UMSATS/SRAD-AvionicsComputer/SRAD_V2/SRAD_V2.csv

Reference | Manufacturer_Part_Number | Manufacturer_Name | DNP | Value | Footprint | Qty | Description | Digikey Link
C1,C4 | GRM1555C1H120FA01J | Murata Electronics |  | 12pF | Capacitor_SMD:C_0402_1005Metric | 2 | 12 pF ±1% 50V Ceramic Capacitor C0G, NP0 0402 (1005 Metric) | https://www.digikey.ca/en/products/detail/murata-electronics/GRM1555C1H120FA01J/4420263
C2,C3,C5,C6,C7,C8,C9,C10,C11,C13,C15,C16,C19,C20,C23,C24,C31,C32,C34,C37,C45,C48,C49,C51 | C0603C104K5RAC3121 | KEMET |  | 100nF | Capacitor_SMD:C_0603_1608Metric | 24 | CAP CER 0.1UF 50V X7R 0603 | https://www.digikey.ca/en/products/detail/kemet/C0603C104K5RAC3121/16680122?gclsrc=aw.ds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
C12,C27 | GRM155R71C103KA01D | Murata Electronics |  | 10nF | Capacitor_SMD:C_0402_1005Metric | 2 | 10000 pF ±10% 16V Ceramic Capacitor X7R 0402 (1005 Metric) | https://www.digikey.ca/en/products/detail/murata-electronics/GRM155R71C103KA01D/587215
C14,C17,C21,C25,C29,C30,C33,C44 | C0603C105K4RACTU | KEMET |  | 1uF | Capacitor_SMD:C_0603_1608Metric | 8 | CAP CER 1UF 16V X7R 0603 | https://www.digikey.ca/en/products/detail/kemet/C0603C105K4RACTU/2199788
C18,C22,C28,C35,C36,C41,C42,C46,C47,C50 | CGA5L1X7R1E106K160DC | TDK |  | 10uF | Capacitor_SMD:C_1206_3216Metric | 10 | 10 µF ±10% 25V Ceramic Capacitor X7R 1206 (3216 Metric) | https://www.digikey.com/en/products/detail/tdk/CGA5L1X7R1E106K160DC/22106123
C26 | C0402C470J3GACTU | KEMET |  | 47pF | Capacitor_SMD:C_0402_1005Metric | 1 | 47 pF ±5% 25V Ceramic Capacitor C0G, NP0 0402 (1005 Metric) | https://www.digikey.ca/en/products/detail/kemet/C0402C470J3GACTU/1933626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
C38,C39,C40 | GRM31CC81E226ME11L | Murata Electronics |  | 22uF | Capacitor_SMD:C_1206_3216Metric | 3 | CAP CER 22UF 25V X6S 1206 | https://www.digikey.com/en/products/detail/murata-electronics/GRM31CC81E226ME11L/7363058
D1,D3 | SMF10CA | Littelfuse Inc. |  | TVS diode | Diode_SMD:D_SOD-123F | 2 | TVS DIODE 10VWM 17VC SOD123F | https://www.digikey.ca/en/products/detail/littelfuse-inc/SMF10CA/11206210
D2,D8,D9,D10,D11 | MSS1P5-M3/89A | Vishay General Semiconductor - Diodes Division |  |  | Schottky_Diode:DIODE_MSP3V3 | 5 | DIODE SCHOTTKY 50V 1A DO219AD | https://www.digikey.ca/en/products/detail/vishay-general-semiconductor-diodes-division/mss1p5-m3-89a/2071754
D4 | MBRA340T3G | onsemi |  | Schottky Diode | Diode_SMD:D_SMA | 1 | 40V 3A Schottky Barrier Rectifier Diode, SMA(DO-214AC) | https://www.digikey.ca/en/products/detail/onsemi/MBRA340T3G/918606
D5,D6 | STS321050B100 | Eaton - Electronics Division |  | TVS diode | Diode_SMD:D_SOD-323 | 2 | 5V, 450W Discrete Bidirectional TVS Diode, SOD-323 | https://www.digikey.ca/en/products/detail/eaton-electronics-division/STS321050B100/13280469
D7 | PTVS3V3S1UTR,115 | Nexperia USA Inc. |  | TVS diode | PTVS3V3S1UTR_115:CR_PTVS3V_NEX-L | 1 | TVS DIODE 3.3VWM 8VC SOD123W | https://www.digikey.ca/en/products/detail/nexperia-usa-inc/PTVS3V3S1UTR-115/2780299
FB1 | MH1608-121Y | Bourns Inc. |  | 120R | Inductor_SMD:L_0603_1608Metric | 1 | Ferrite bead | https://www.digikey.ca/en/products/detail/bourns-inc/MH1608-121Y/2563311?gclsrc=aw.ds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
FU1,FU2,FU3,FU4 | SF-1206SP500M-2 | Bourns Inc. |  | Fuse_Small | Fuse:Fuse_1206_3216Metric_Pad1.42x1.75mm_HandSolder | 4 | Fuse, small symbol | https://www.digikey.ca/en/products/detail/bourns-inc/sf-1206sp500m-2/8548151
IC1 | STM32F767ZIT6 | STMicroelectronics |  |  | Package_QFP:LQFP-144_20x20mm_P0.5mm | 1 | STMicroelectronics Arm Cortex-M7 MCU, 2048KB flash, 512KB RAM, 216 MHz, 1.7-3.6V, 114 GPIO, LQFP144 | https://www.digikey.ca/en/products/detail/stmicroelectronics/STM32F767ZIT6/6004736
IC2 | LSM6DSVTR | STMicroelectronics |  |  | LGA14-L_2P59X3P1X0P5_STM | 1 | INEMO INERTIAL MODULE: 3D ACCELE | https://www.digikey.ca/en/products/detail/stmicroelectronics/LSM6DSVTR/17038915
IC3 | MAX-M10S-00B | u-blox |  |  | RF_GPS:ublox_MAX | 1 | GNSS Module MAX M10, VCC 1.65V to 3.6V | https://www.digikey.ca/en/products/detail/u-blox/MAX-M10S-00B/15712906
IC4 | MMC5983MA | Memsic Inc. |  |  | MMC5983MA:MMC5983MA_MEM | 1 | SEN MR I2C/SPI 16-LGA | https://www.digikey.ca/en/products/detail/memsic-inc/mmc5983ma/10452795
IC5 | AS5F31G04SND-08LIN | Alliance Memory, Inc. |  |  | NAND_Flash:SON127P600X800X80-8N | 1 | IC FLASH 1GBIT SPI/QUAD 8LGA | https://www.digikey.com/en/products/detail/alliance-memory-inc/AS5F31G04SND-08LIN/13282909
IC6 | MS560702BA03-50 | TE Connectivity Measurement Specialties |  |  | Package_LGA:LGA-8_3x5mm_P1.25mm | 1 | Barometric pressure sensor, 20cm resolution, 10 to 1200 mbar, I2C and SPI interface up to 20MHz, LGA-8 | https://www.digikey.ca/en/products/detail/te-connectivity-measurement-specialties/MS560702BA03-50/4700931
IC7 | TPS563200DDCT | Texas Instruments |  |  | Package_TO_SOT_SMD:SOT-23-6 | 1 | 3A Synchronous Step-Down Voltage Regulator, Adjustable Output Voltage, 4.5-17V Input Voltage, SOT-23-6 | https://www.digikey.ca/en/products/detail/texas-instruments/TPS563200DDCT/5012066
IC8 | TMCS1108A2UQDR | Texas Instruments |  |  | Current_Sensor:D0008A-IPC_A | 1 | SENSOR CURRENT HALL EFFECT 8SOIC | https://www.digikey.ca/en/products/detail/texas-instruments/TMCS1108A2UQDR/13692878
IC9,IC10 | NCV81071BZR2G | onsemi |  |  | Gate_Driver:SOP65P490X110-9N | 2 | Low-Side Gate Driver IC CMOS, TTL 8-MSOP-EP | https://www.digikey.ca/en/products/detail/onsemi/NCV81071BZR2G/25602407
IC11 | TS941ILT | STMicroelectronics |  | op-amp | SOT23-5L_STM | 1 | IC OP AMP 1CH SOT-23-5 | https://www.digikey.ca/en/products/detail/stmicroelectronics/ts941ilt/720968
J3 | RSP-122811-02 | Samtec Inc. |  |  | RSP_122811_02-2:SAMTEC_RSP-122811-02 | 1 | CONN IPEX MHF3 RCP STR 50OHM SMD | https://www.digikey.ca/en/products/detail/samtec-inc/RSP-122811-02/6678589
L1 | LQG15HS27NH02D | Murata Electronics |  | 27nH | Inductor_SMD:L_0402_1005Metric | 1 | Inductor, small symbol | https://www.digikey.ca/en/products/detail/murata-electronics/lqg15hs27nh02d/6798538
L2 | SRP5030TA-2R2M | Bourns Inc. |  | 2.2uH | Inductor_SMD:L_Bourns_SRP5030T | 1 | FIXED IND 2.2UH 5.5A 35 MOHM SMD | https://www.digikey.ca/en/products/detail/bourns-inc/srp5030ta-2r2m/5429671
LED1,LED2,LED3 | 150120SS75000 | Würth Elektronik |  | LED | 150120SS75000:WL-SMCW_1206 | 3 | RED SMD LED | https://www.digikey.ca/en/products/detail/würth-elektronik/150120SS75000/4489942?_gl=1*tss2ya*_up*MQ..*_gs*MQ..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
Q1,Q2,Q3,Q4 | NTMFS5C673NT1G | onsemi |  | MOSFET N-CH | NTMFS5C673NT1G-2:TRANS_NTMFS5C673NT1G | 4 | MOSFET N-CH 60V 14A/50A 5DFN | https://www.digikey.ca/en/products/detail/onsemi/ntmfs5c673nt1g/12525778
Q5 | MMBT3904LT3G | onsemi |  | NPN BJT | Package_TO_SOT_SMD:SOT-23 | 1 | TRANS NPN 40V 0.2A SOT23-3 | https://www.digikey.ca/en/products/detail/onsemi/mmbt3904lt3g/919602
R1,R4,R15,R20,R21,R22,R23 | CRT0603-BY-1002ELF | Bourns Inc. |  | 10k | Resistor_SMD:R_0603_1608Metric | 7 | RES SMD 10K OHM 0.1% 1/10W 0603 | https://www.digikey.ca/en/products/detail/bourns-inc/crt0603-by-1002elf/1775019
R2,R7,R10,R11,R24 | RT0603BRD07806RL | YAGEO |  | 806R | Resistor_SMD:R_0603_1608Metric | 5 | 806 Ohms ±0.1% 0.1W, 1/10W Chip Resistor 0603 (1608 Metric) Thin Film | https://www.digikey.ca/en/products/detail/yageo/RT0603BRD07806RL/1072652
R3,R5,R6,R9,R12,R13 | CRCW06034K70FKEAHP | Vishay Dale |  | 4.7k | Resistor_SMD:R_0603_1608Metric | 6 | RES SMD 4.7K OHM 1% 1/3W 0603 | https://www.digikey.ca/en/products/detail/vishay-dale/CRCW06034K70FKEAHP/2222257
R8,R16,R17,R18,R19 | RC1206JR-7W10RL | YAGEO |  | 10R | Resistor_SMD:R_1206_3216Metric | 5 | RES 10 OHM 5% 1/2W 1206 | https://www.digikey.ca/en/products/detail/yageo/RC1206JR-7W10RL/12698862?gclsrc=aw.ds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
R14 | CRCW060333K2FKTA | Vishay Dale |  | 33.2k | Resistor_SMD:R_0603_1608Metric | 1 | RES SMD 33.2K OHM 1% 1/10W 0603 | https://www.digikey.ca/en/products/detail/vishay-dale/crcw060333k2fkta/1222007
R25 | CRG0603F68K | TE Connectivity Passive Product |  | 68k | Resistor_SMD:R_0603_1608Metric | 1 | RES SMD 68K OHM 1% 1/10W 0603 | https://www.digikey.ca/en/products/detail/te-connectivity-passive-product/crg0603f68k/2380803
R26 | RT0603FRD07100KL | YAGEO |  | 100k | Resistor_SMD:R_0603_1608Metric | 1 | RES SMD 100K OHM 1% 1/10W 0603 | https://www.digikey.ca/en/products/detail/yageo/rt0603frd07100kl/5928951
R27 | RMCF0603JT20K0 | Stackpole Electronics Inc |  | 20k | Resistor_SMD:R_0603_1608Metric | 1 | RES 20K OHM 5% 1/10W 0603 | https://www.digikey.ca/en/products/detail/stackpole-electronics-inc/rmcf0603jt20k0/1758001
R28 | RT0603FRE07510KL | YAGEO |  | 500k | Resistor_SMD:R_0603_1608Metric | 1 | RES SMD 510K OHM 1% 1/10W 0603 | https://www.digikey.ca/en/products/detail/yageo/rt0603fre07510kl/5929192
SW1 | SLW-913535-2A-SMT | Same Sky (Formerly CUI Devices) |  |  | spdt_switch:SW_SLW-913535-2A-SMT | 1 | SWITCH SLIDE DPDT 0.1A 12V | https://www.digikey.ca/en/products/detail/omron-electronics-inc-emc-div/B3U-1100P/1534339?gclsrc=aw.ds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
SW2 | B3U-1100P | Aratas (Formerly Omron Components) |  |  | push_button:SW_TS18-5-15-SL-160-SMT-TR | 1 | SWITCH TACTILE SPST-NO 0.05A 12V | https://www.digikey.ca/en/products/detail/omron-electronics-inc-emc-div/B3U-1100P/1534339?gclsrc=aw.ds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
U1 | LM4040CYM3-4.1-TR | Microchip Technology |  | Vol Ref. | Package_TO_SOT_SMD:SOT-23 | 1 | Shunt Voltage Reference IC Fixed 4.096V V ±0.5% 15 mA SOT-23-3 | https://www.digikey.ca/en/products/detail/microchip-technology/lm4040cym3-4-1-tr/1027695
USB1 | USB4105-GF-A | GCT |  | USB_C_Receptacle_USB2.0_16P | Connector_USB:USB_C_Receptacle_GCT_USB4105-xx-A_16P_TopMnt_Horizontal | 1 | USB 2.0-only 16P Type-C Receptacle connector | https://www.digikey.ca/en/products/detail/gct/USB4105-GF-A/11198441
X1 | VXM7-9032-25M0000000 | Microchip Technology |  | Crystal | VXM7_9032_25M0000000:VXM7_MCH | 1 | CRYSTAL 25.0000MHZ SMD | https://www.digikey.ca/en/products/detail/microchip-technology/VXM7-9032-25M0000000/13175115
BZ1 | CI12E-05T230-C-6 | Challenge Electronics | DNP | Buzzer | Buzzer_Beeper:Buzzer_12x9.5RM7.6 | 1 | Buzzer, polarized | https://www.digikey.ca/en/products/detail/challenge-electronics/CI12E-05T230-C-6/21262928
C43 | A750MW228M1CAAE010 | KEMET | DNP | 2200uF | Capacitor_THT:CP_Radial_D10.0mm_P5.00mm | 1 | CAP ALUM POLY 2200UF 20% 16V TH | https://www.digikey.ca/en/products/detail/kemet/A750MW228M1CAAE010/13420077
EM1,EM2,EM3,EM4 | 691210910002 | Würth Elektronik | DNP |  | Screw_Terminal:691210910002 | 4 | TERM BLOCK 2P HORIZON 2.54MM PCB | https://www.digikey.ca/en/products/detail/würth-elektronik/691210910002/10668428
J1,J6,J7 |  |  | DNP | Conn_01x04_Pin | Connector_PinHeader_2.54mm:PinHeader_1x04_P2.54mm_Vertical | 3 | Generic connector, single row, 01x04, script generated
J2,J4 | S02B-XASS-1 | JST Sales America Inc. | DNP |  | S02B-XASS-1:CONN2_S02B-XASS_295x496_JST | 2 | CONN HEADER R/A 2POS 2.5MM | https://www.digikey.ca/en/products/detail/jst-sales-america-inc/S02B-XASS-1/1634785
J5 |  |  | DNP | Conn_01x02_Pin | Connector_PinHeader_1.27mm:PinHeader_1x02_P1.27mm_Vertical | 1 | Generic connector, single row, 01x02, script generated
