UMSATS/SRAD-AvionicsComputer/SRAD_V2/SRAD_FC_PCB_LAYOUT.csv

 | Sourced | Placed | References | Value | Footprint | Quantity
1 |  |  | C3, C7, C8, C9, C11, C16, C18, C21, C23, C24, C25, C26, C27, C28, C29, C30, C31, C32, C33, C34, C39, C42, Cin4 | 100n | C_0603_1608Metric | 23
2 |  |  | C1, C2, C5, C6, C13, C14, C15, C20, C22, C35 | 10u | C_1206_3216Metric | 10
3 |  |  | C17, C36, C38, C45, C46, C47, C48, C49 | 1u | C_0603_1608Metric | 8
4 |  |  | C40, C41 | 12p | C_0402_1005Metric | 2
5 |  |  | C12 | 2200uF | CP_Radial_D10.0mm_P5.00mm | 1
6 |  |  | C19 | 10n | C_0402_1005Metric | 1
7 |  |  | C37 | 10n | R_0402_1005Metric | 1
8 |  |  | C44 | 47pF | C_0402_1005Metric | 1
9 |  |  | R2, R8, R9, R10, R11, R12, R17 | 10k | R_0603_1608Metric | 7
10 |  |  | R14, R15, R16, R18, R19, R21 | 4.7k | R_0603_1608Metric | 6
11 |  |  | R3, R4, R5, R6, R7 | 10R | R_1206_3216Metric | 5
12 |  |  | R13, R22, R23 | 806R | R_0603_1608Metric | 3
13 |  |  | R1 | 33.2k | R_0603_1608Metric | 1
14 |  |  | L1 | 2.2uH | IND_BOURNS_SRN8040 | 1
15 |  |  | L2 | 27n | L_0402_1005Metric | 1
16 |  |  | D5, D6 | SD05C-01F | D_SOD-323 | 2
17 |  |  | D7, D8 | MBR1020VL | D_SOD-123F | 2
18 |  |  | D1 | WL-SMCW_1206 | WL-SMCW_1206 | 1
19 |  |  | D4 | MBRA340 | D_SMA | 1
20 |  |  | U1 | STM32F767ZIT6 | LQFP-144_20x20mm_P0.5mm | 1
21 |  |  | U2 | TPS563200 | SOT-23-6 | 1
22 |  |  | U3 | TMCS1108A2UQDR | D0008A-IPC_A | 1
23 |  |  | U5 | LSM6DSVTR | LGA14-L_2P59X3P1X0P5_STM | 1
24 |  |  | U12 | MAX-M10S | ublox_MAX | 1
25 |  |  | U13 | MS5607-02BA | LGA-8_3x5mm_P1.25mm | 1
26 |  |  | U14 | MMC5983MA | MMC5983MA_MEM | 1
27 |  |  | U17 | AS5F31G04SND-08LIN | SON127P600X800X80-8N | 1
28 |  |  | X1 | Crystal | VXM7_MCH | 1
29 |  |  | F1, F2, F3, F4 | Fuse_Small | Fuse_1206_3216Metric_Pad1.42x1.75mm_HandSolder | 4
30 |  |  | CR1, CR2, CR3, CR4, CR6 | MSS1P5-M3/89A | DIODE_MSP3V3 | 5
31 |  |  | EM1, EM2, EM3, EM4 | 691210910002 | 691210910002 | 4
32 |  |  | Q1, Q2, Q3, Q4 | NTMFS5C673NT1G | TRANS_NTMFS5C673NT1G | 4
33 |  |  | Cout1, Cout2, Cout3 | 22uF | C_1206_3216Metric | 3
34 |  |  | IC1, IC2 | NCV81071BZR2G | SOP65P490X110-9N | 2
35 |  |  | BZ2 | Buzzer | Buzzer_12x9.5RM7.6 | 1
36 |  |  | CR5 | PTVS3V3S1UTR_115 | CR_PTVS3V_NEX-L | 1
37 |  |  | FB1 | 120R | L_0603_1608Metric | 1
38 |  |  | Q6 | MMBT3904LT3G | SOT-23 | 1
39 |  |  | S1 | TS18-5-15-SL-160-SMT-TR | SW_TS18-5-15-SL-160-SMT-TR | 1
40 |  |  | S2 | SLW-913535-2A-SMT | SW_SLW-913535-2A-SMT | 1
41 |  |  | J5, J7 | S02B-XASS-1LFSN | CONN2_S02B-XASS_295x496_JST | 2
42 |  |  | J1 | Conn_01x04_Pin | PinHeader_1x04_P2.54mm_Vertical | 1
43 |  |  | J2 | Conn_01x02_Pin | PinHeader_1x02_P1.27mm_Vertical | 1
44 |  |  | J3 | RSP-122811-02 | SAMTEC_RSP-122811-02 | 1
45 |  |  | J4 | USB_C_Receptacle_USB2.0_16P | USB_C_Receptacle_GCT_USB4105-xx-A_16P_TopMnt_Horizontal | 1
