UMSATS/SRAD-AvionicsComputer/Breakout Boards/Custom E-CAD Models/0.1uf Cap/ul_C0603C104K5RAC3121/CAP_C0603C104K5RAC3121_KEM.step

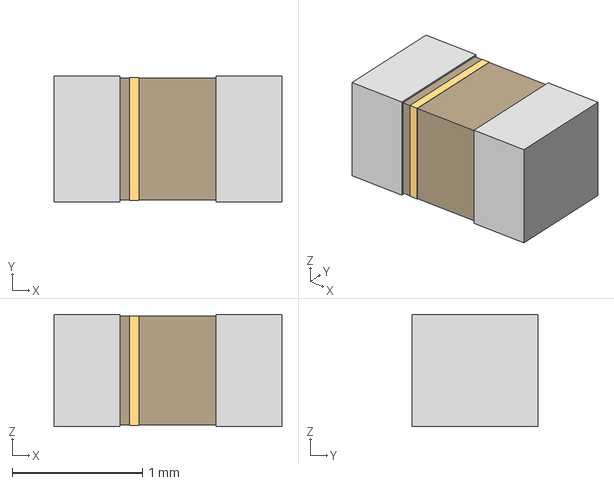
[picture p3: CAD file, 2026-09-25]
Breakout Boards/Custom E-CAD Models/0.1uf Cap/ul_C0603C104K5RAC3121/CAP_C0603C104K5RAC3121_KEM.step
1.75 x 0.966 x 0.864 mm
