UMSATS/SRAD-AvionicsComputer/Breakout Boards/Custom E-CAD Models/3D Models/2.7mF Polymer Capacitor/APSG160ELL272MJ20S.STEP

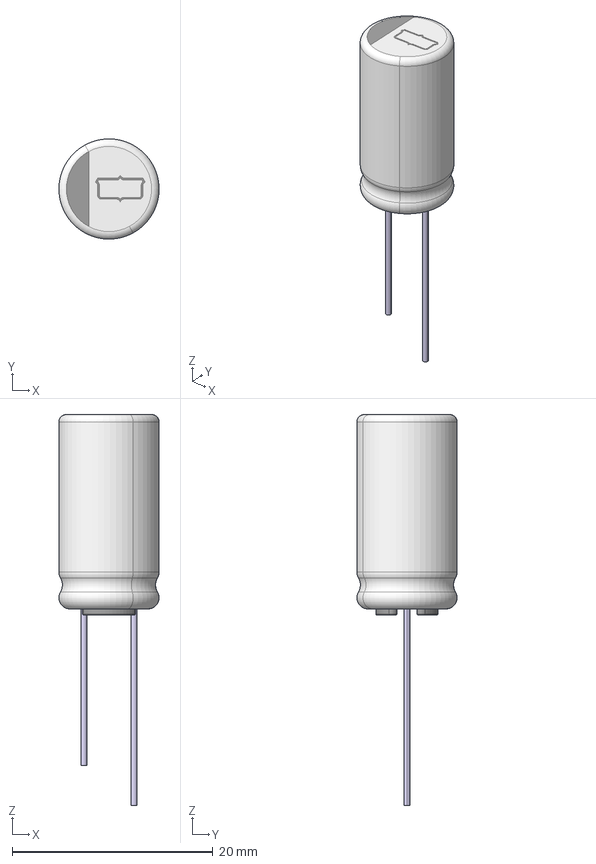
[picture p4: CAD file, 2026-09-25]
Breakout Boards/Custom E-CAD Models/3D Models/2.7mF Polymer Capacitor/APSG160ELL272MJ20S.STEP
10.00 x 10.00 x 39.0 mm
A-LEAD_D10_TERMINAL+
A-LEAD_D10_TERMINAL-
A-LEAD_D10_L20_ELEMENT
