UMSATS/SRAD-AvionicsComputer/Breakout Boards/Custom E-CAD Models/3D Models/GP_1575_18_4_A_02/gp_1575_18_4_a_02.stp

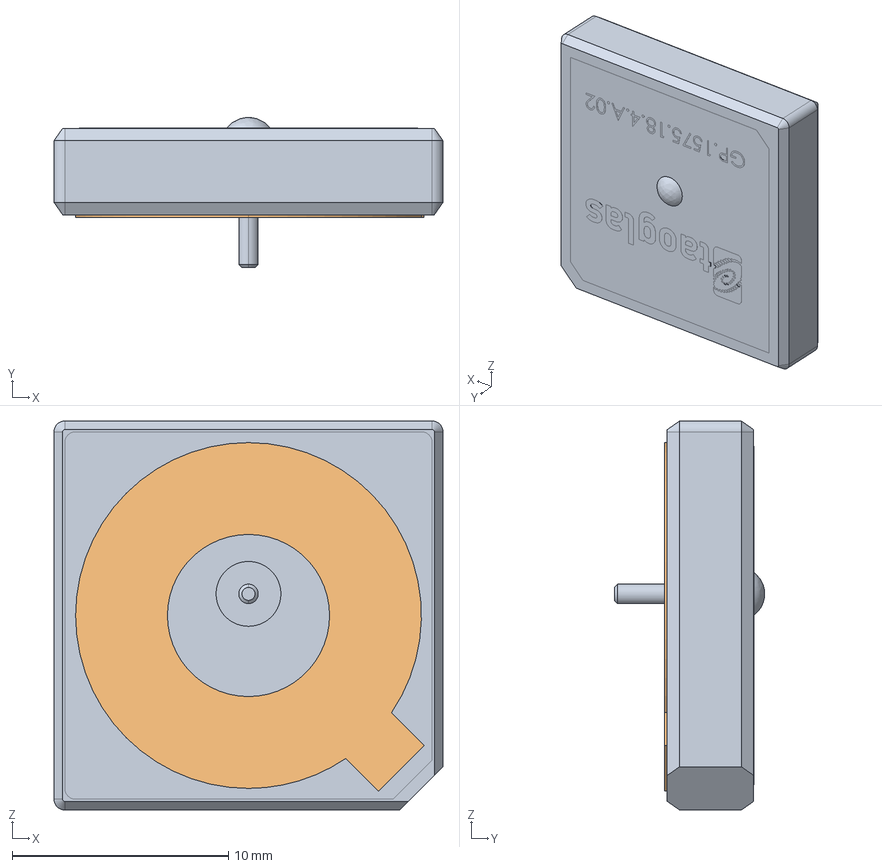
[picture p5: CAD file, 2026-09-25]
Breakout Boards/Custom E-CAD Models/3D Models/GP_1575_18_4_A_02/gp_1575_18_4_a_02.stp
18.0 x 6.96 x 18.0 mm
