UMSATS/SRAD-AvionicsComputer/Breakout Boards/Custom E-CAD Models/3D Models/Temp Sensor/DFN8_2x3MC_MCH.step

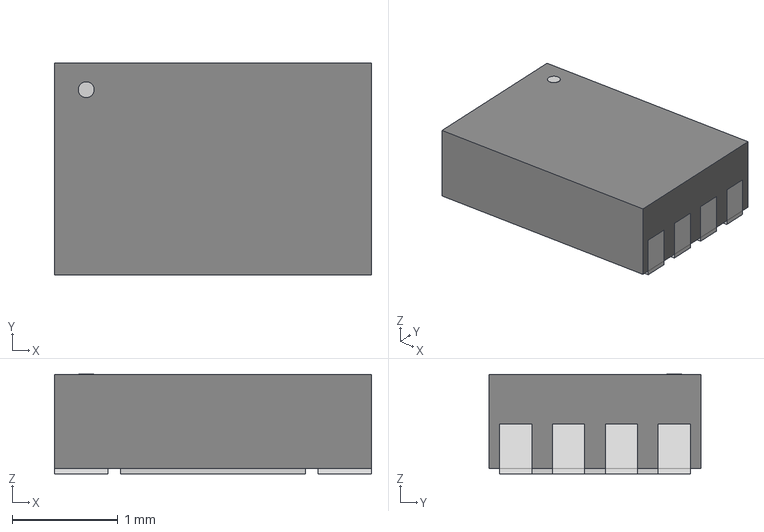
[picture p6: CAD file, 2026-09-25]
Breakout Boards/Custom E-CAD Models/3D Models/Temp Sensor/DFN8_2x3MC_MCH.step
3.00 x 2.01 x 0.942 mm
