UMSATS/SRAD-AvionicsComputer/Breakout Boards/Custom E-CAD Models/Aluminum 6.8mF/Download_STP_860010x8002x+(rev1).stp

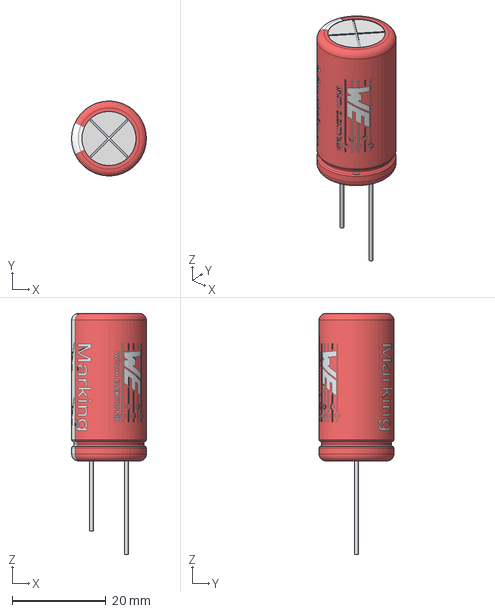
[picture p7: CAD file, 2026-09-25]
Breakout Boards/Custom E-CAD Models/Aluminum 6.8mF/Download_STP_860010x8002x+(rev1).stp
16.0 x 16.0 x 51.5 mm
