UMSATS/SRAD-AvionicsComputer/Breakout Boards/Custom E-CAD Models/Mosfet/ul_FDD1600N10ALZ/TO252_FDD1600_ONS.step

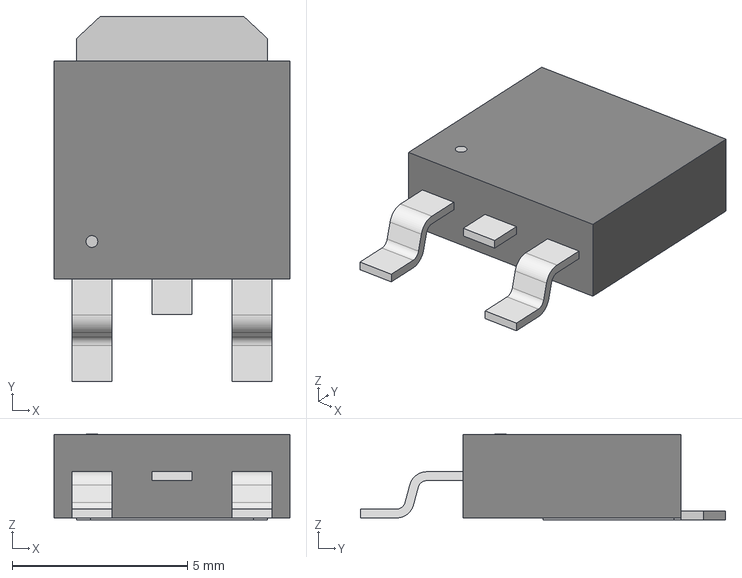
[picture p8: CAD file, 2026-09-25]
Breakout Boards/Custom E-CAD Models/Mosfet/ul_FDD1600N10ALZ/TO252_FDD1600_ONS.step
6.73 x 10.4 x 2.44 mm
