UMSATS/SRAD-AvionicsComputer/Breakout Boards/Custom E-CAD Models/NTMFSS0D9N03P8/3D/NTMFSS0D9N03P8.stp

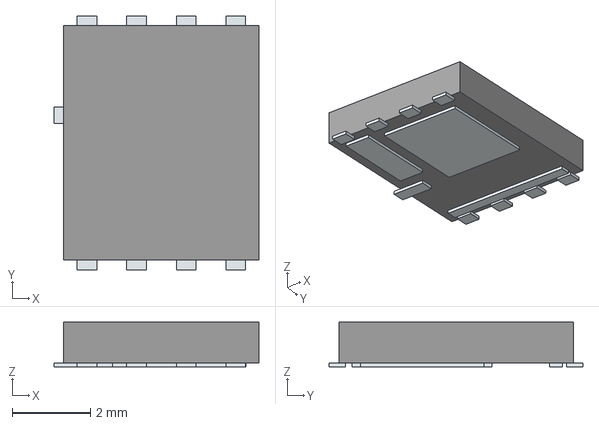
[picture p9: CAD file, 2026-09-25]
Breakout Boards/Custom E-CAD Models/NTMFSS0D9N03P8/3D/NTMFSS0D9N03P8.stp
5.25 x 6.51 x 1.15 mm
Pins
