UMSATS/SRAD-AvionicsComputer/Breakout Boards/Custom E-CAD Models/PTVS3V3S1UTR_115/CR_PTVS3V_NEX.step

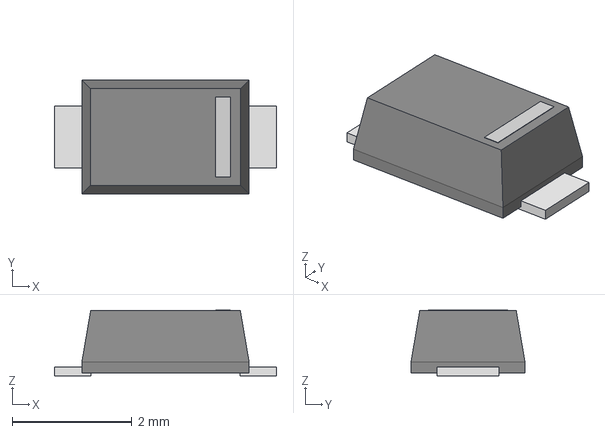
[picture p10: CAD file, 2026-09-25]
Breakout Boards/Custom E-CAD Models/PTVS3V3S1UTR_115/CR_PTVS3V_NEX.step
3.71 x 1.90 x 1.10 mm
