UMSATS/SRAD-AvionicsComputer/Breakout Boards/Custom E-CAD Models/SMF10CA/SOD-123F_LTF.step

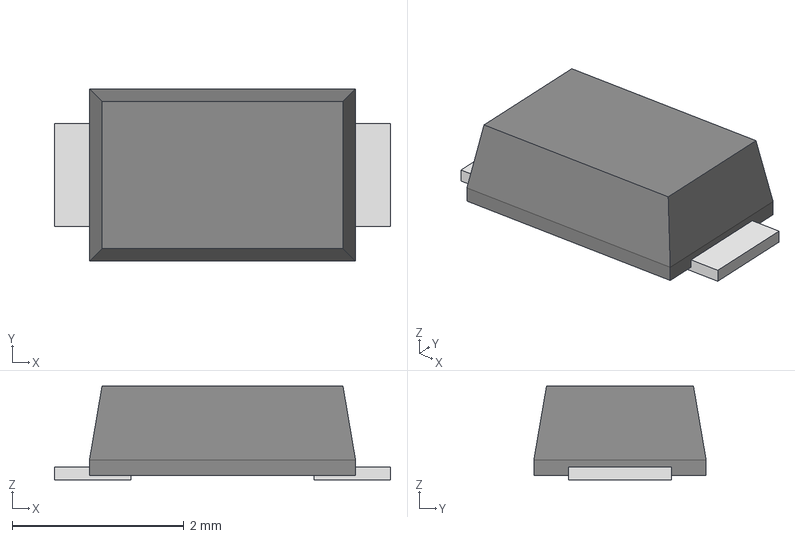
[picture p11: CAD file, 2026-09-25]
Breakout Boards/Custom E-CAD Models/SMF10CA/SOD-123F_LTF.step
3.91 x 2.01 x 1.09 mm
