UMSATS/SRAD-AvionicsComputer/Footprints/AS5F31G04SND-08LIN.step

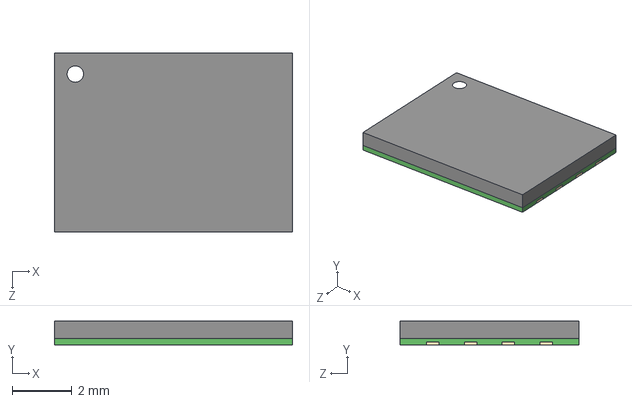
[picture p12: CAD file, 2025-06-01]
Footprints/AS5F31G04SND-08LIN.step
8.00 x 0.8 x 6.00 mm
