UMSATS/SRAD-AvionicsComputer/SRAD_V2/Custom E-CAD Models/3D Models/6.8uH Inductor/IND_IHLP-4040DZ_VIS.step

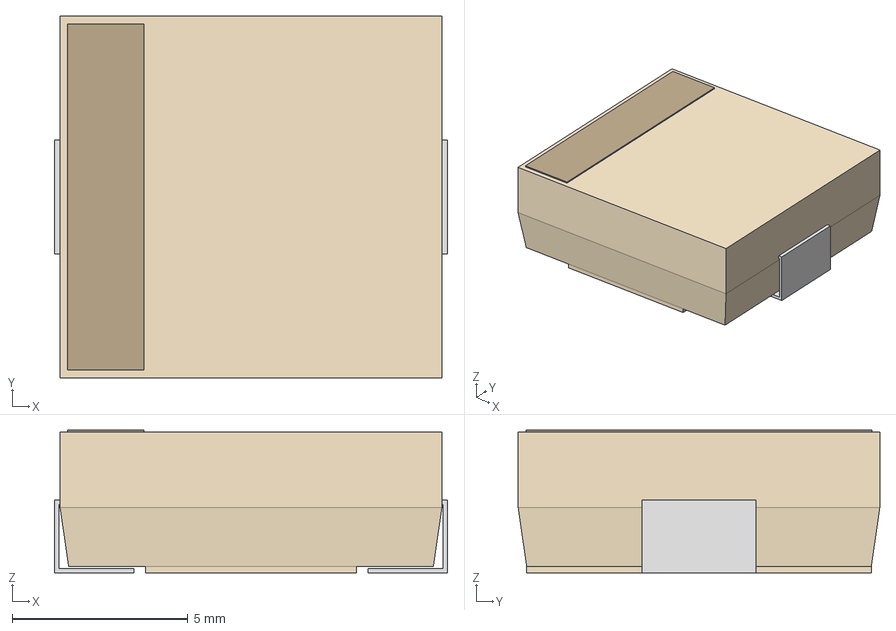
[picture p13: CAD file, 2026-07-21]
SRAD_V2/Custom E-CAD Models/3D Models/6.8uH Inductor/IND_IHLP-4040DZ_VIS.step
11.2 x 10.3 x 4.06 mm
