UMSATS/SRAD-AvionicsComputer/SRAD_V2/Custom E-CAD Models/3D Models/IMU/QFN_LSM6DSV80XTR_STM.step

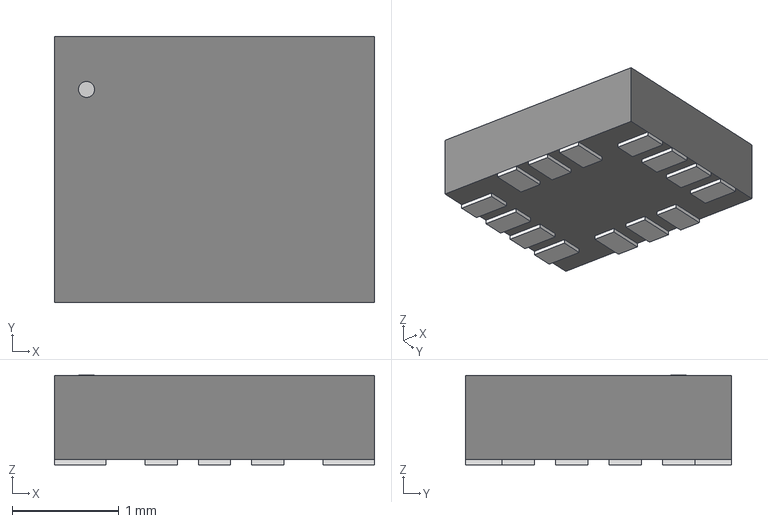
[picture p14: CAD file, 2026-05-08]
SRAD_V2/Custom E-CAD Models/3D Models/IMU/QFN_LSM6DSV80XTR_STM.step
3.00 x 2.49 x 0.841 mm
