UMSATS/SRAD-AvionicsComputer/SRAD_V2/Custom E-CAD Models/3D Models/Magnometer/MMC5983MA_MEM.step

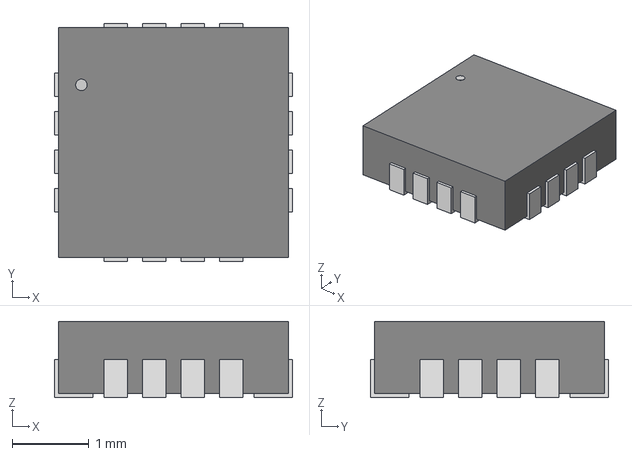
[picture p15: CAD file, 2026-05-14]
SRAD_V2/Custom E-CAD Models/3D Models/Magnometer/MMC5983MA_MEM.step
3.10 x 3.10 x 0.993 mm
