UMSATS/SRAD-AvionicsComputer/SRAD_V2/Custom E-CAD Models/3D Models/MCU/STM32F767ZIT6.step

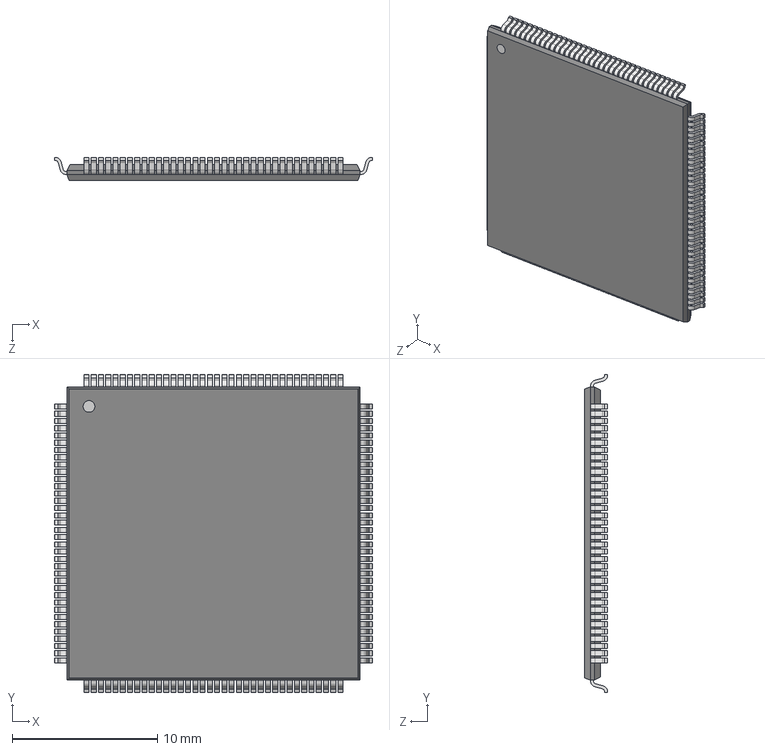
[picture p16: CAD file, 2026-05-07]
SRAD_V2/Custom E-CAD Models/3D Models/MCU/STM32F767ZIT6.step
21.9 x 21.9 x 1.60 mm
