UMSATS/SRAD-AvionicsComputer/SRAD_V2/Custom E-CAD Models/3D Models/SMD-Led/SML-LXT0805IW-TR.step

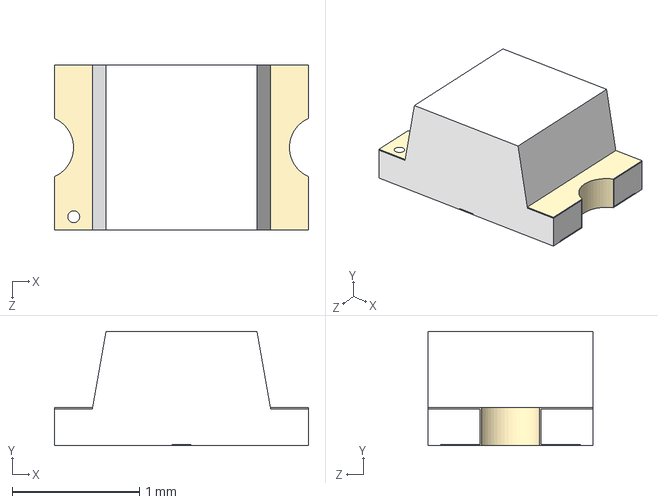
[picture p17: CAD file, 2026-02-22]
SRAD_V2/Custom E-CAD Models/3D Models/SMD-Led/SML-LXT0805IW-TR.step
2.00 x 0.9 x 1.30 mm
