UMSATS/SRAD-AvionicsComputer/SRAD_V2/Custom E-CAD Models/LSM6DSVTR/LGA14-L_2P59X3P1X0P5_STM.step

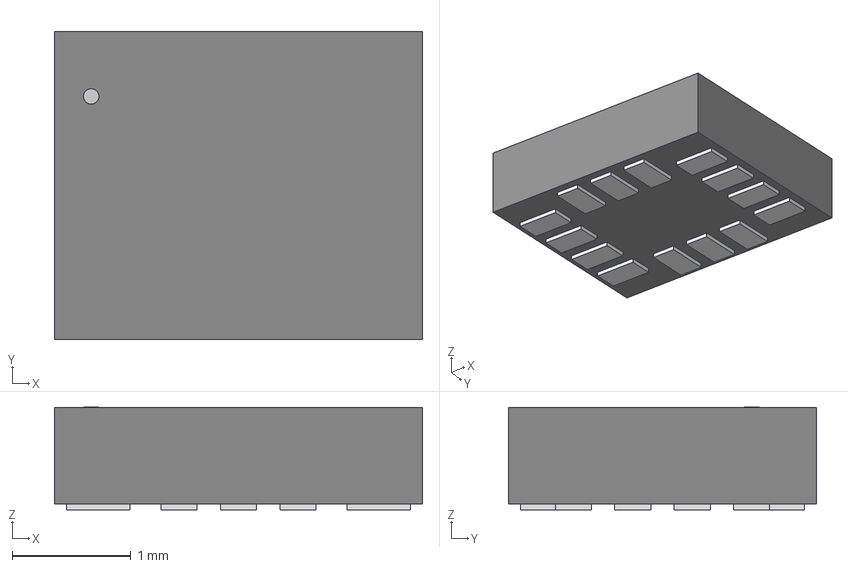
[picture p18: CAD file, 2026-08-27]
SRAD_V2/Custom E-CAD Models/LSM6DSVTR/LGA14-L_2P59X3P1X0P5_STM.step
3.10 x 2.59 x 0.866 mm
