UMSATS/SRAD-AvionicsComputer/SRAD_V2/Custom E-CAD Models/Mosfet/ul_FDC8878/SuperSot6_SOT-23-6_1P6X2P9_ONS.step

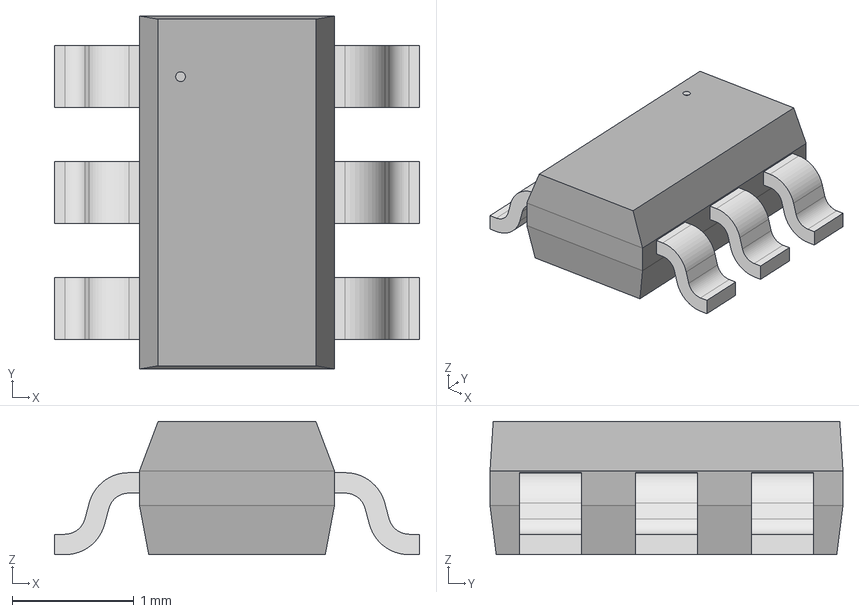
[picture p19: CAD file, 2026-02-22]
SRAD_V2/Custom E-CAD Models/Mosfet/ul_FDC8878/SuperSot6_SOT-23-6_1P6X2P9_ONS.step
3.00 x 2.90 x 1.09 mm
