UMSATS/SRAD-AvionicsComputer/SRAD_V2/Custom E-CAD Models/S02B-XASS-1/S02B-XASS-1.STEP

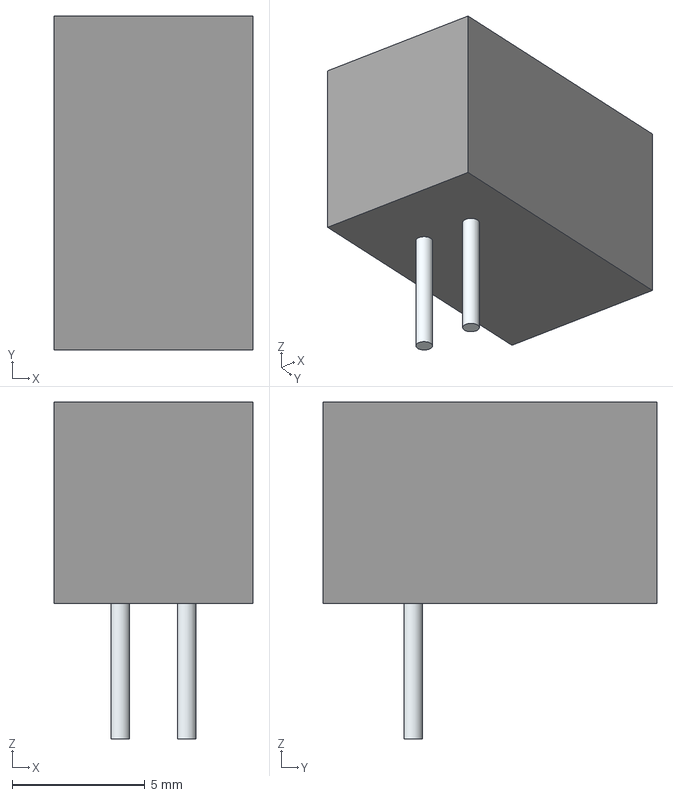
[picture p20: CAD file, 2026-08-29]
SRAD_V2/Custom E-CAD Models/S02B-XASS-1/S02B-XASS-1.STEP
7.50 x 12.6 x 12.7 mm
Leads
