UMSATS/SRAD-AvionicsComputer/SRAD_V2/Custom E-CAD Models/TS941ILT/SOT23-5L_STM.step

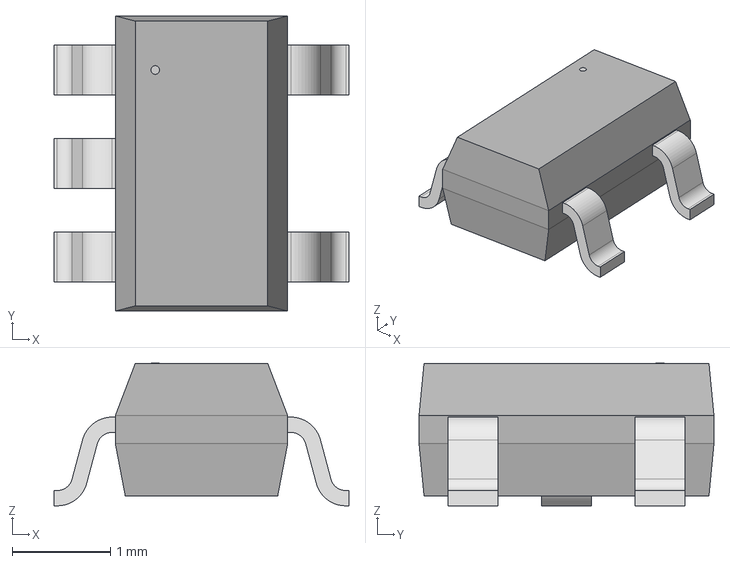
[picture p21: CAD file, 2026-09-06]
SRAD_V2/Custom E-CAD Models/TS941ILT/SOT23-5L_STM.step
3.00 x 3.00 x 1.45 mm
