UMSATS/SRAD-AvionicsComputer/SRAD_V2/Custom E-CAD Models/VXM7_9032_25M0000000/VXM7_MCH.step

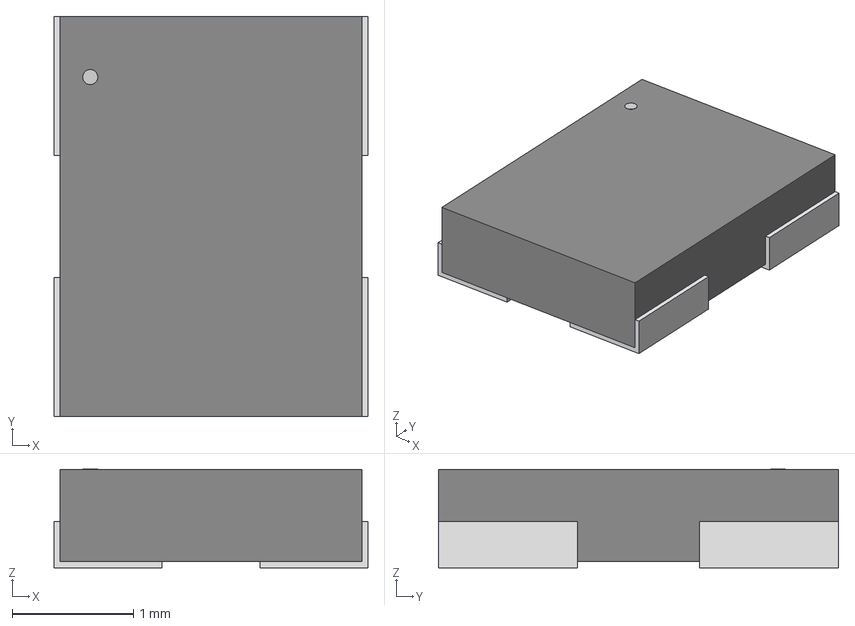
[picture p22: CAD file, 2026-08-19]
SRAD_V2/Custom E-CAD Models/VXM7_9032_25M0000000/VXM7_MCH.step
2.59 x 3.30 x 0.815 mm
