UMSATS/SRAD-AvionicsComputer/(list of files, cad)

Other CAD files:
SRAD_V2/Custom E-CAD Models/3D Models/NAND Flash/AS5F31G04SND-08LIN.step
SRAD_V1/E-Cad Models/MCU/ul_STM32F767ZIT6/LQFP144-20x20mm_STM.step
