UMSATS/SRAD-AvionicsComputer/SRAD_V2/SRAD_V2.pdf

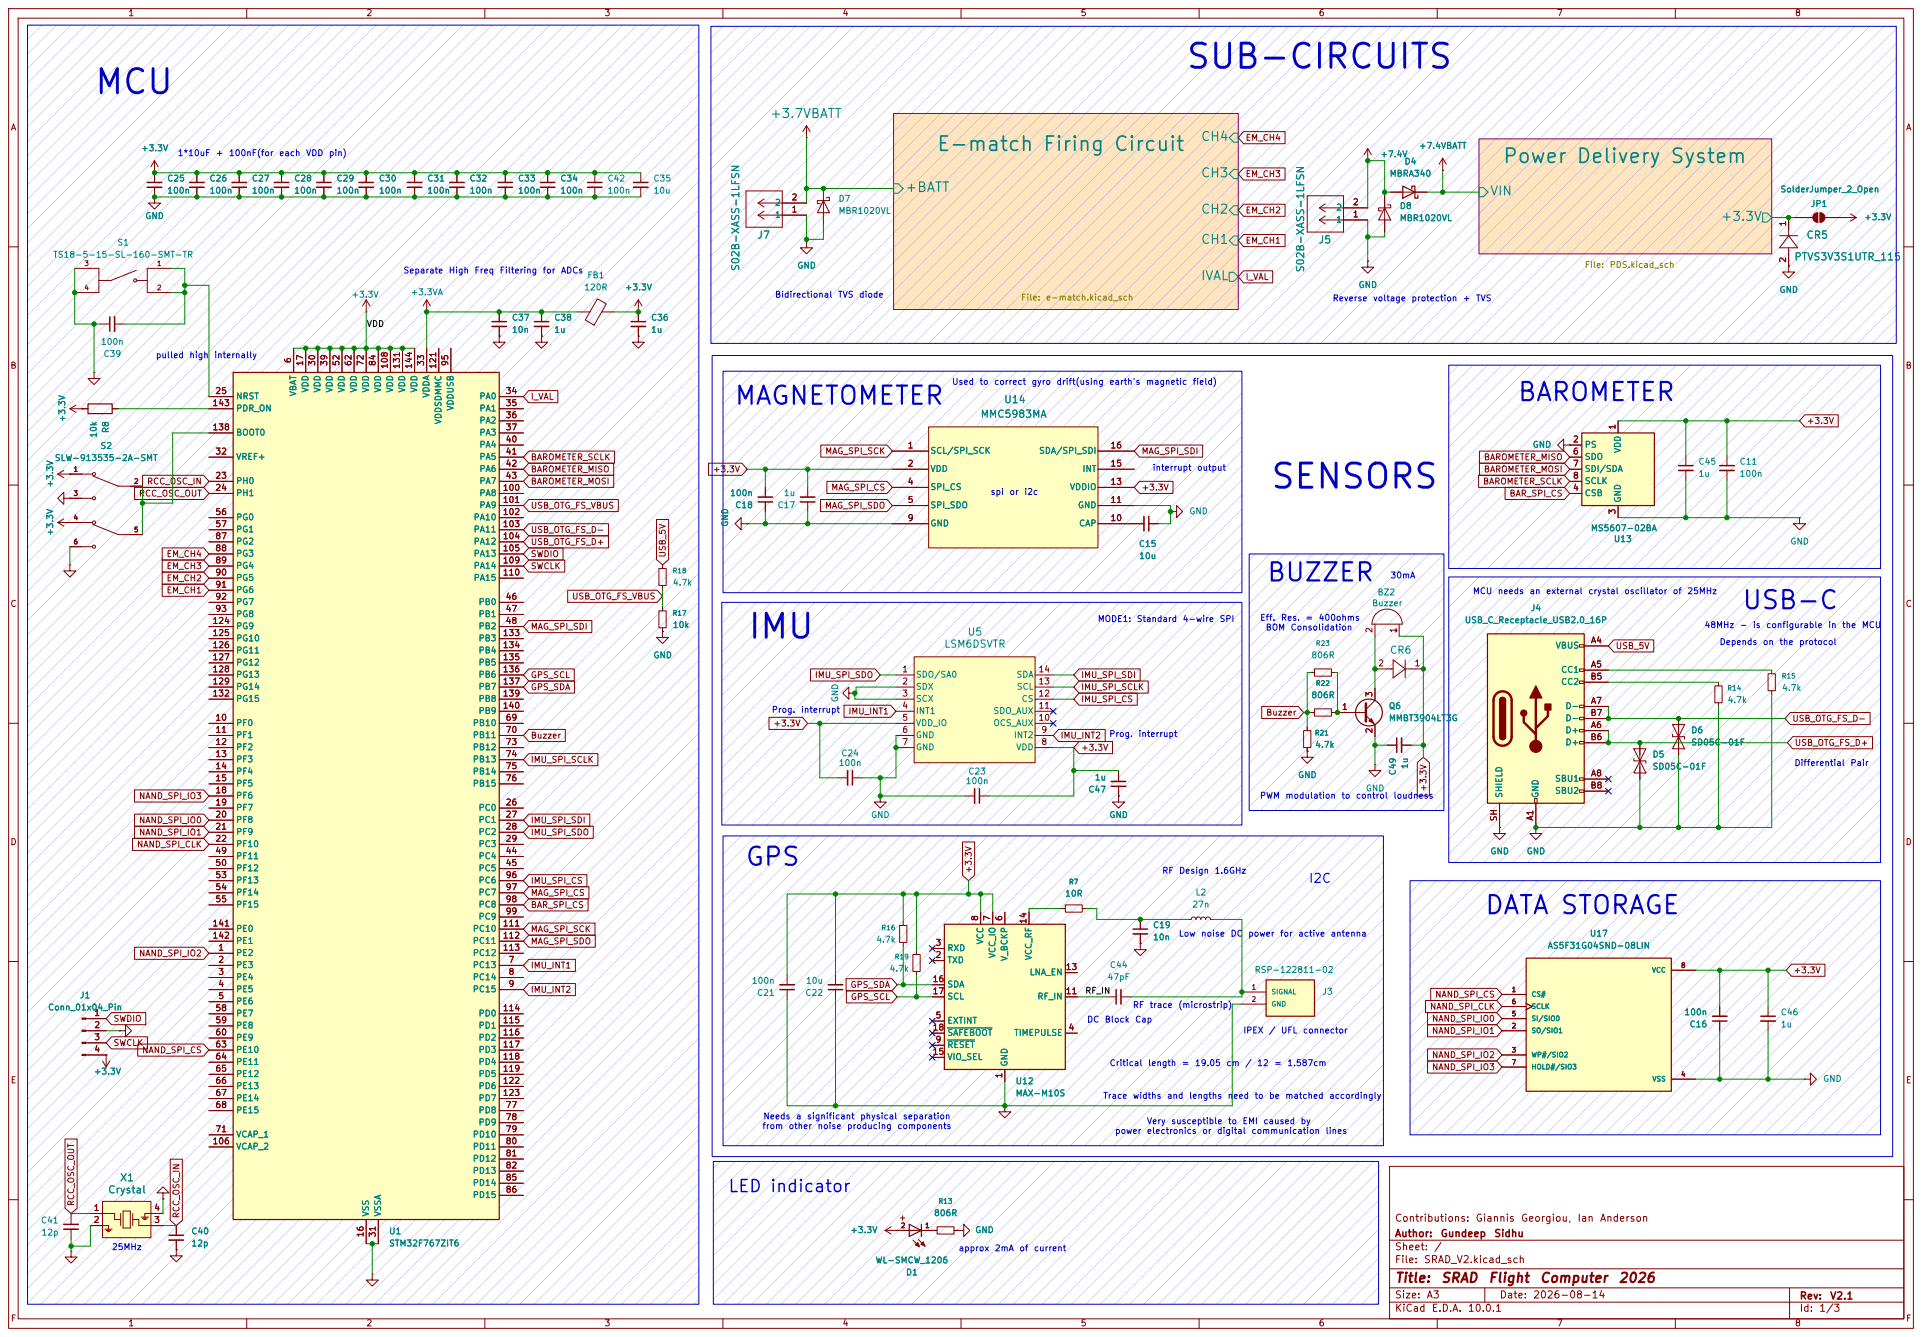
[picture p23: page 1]

1*10uF + 100nF(for each VDD pin)

spi or i2c Used to correct gyro drift(using earth's magnetic field) Bidirectional TVS diode MAGNETOMETER

MCU needs an external crystal oscillator of 25MHz GPS

IPEX / UFL connector IMU

48MHz - is configurable in the MCU

VDD_IO 5 GND 6 GND 7

RF trace (microstrip) Trace widths and lengths need to be matched accordingly
DC Block Cap

Needs a significant physical separation
from other noise producing components

Very susceptible to EMI caused by power electronics or digital communication lines

Contributions: Giannis Georgiou, Ian Anderson
Author: Gundeep Sidhu
Sheet: /
File: SRAD_V2.kicad_sch
Title: SRAD Flight Computer 2026

Size: A3 | Rev: V2.1 | F Date: 2026-08-14
KiCad E.D.A. 10.0.1 | Id: 1/3

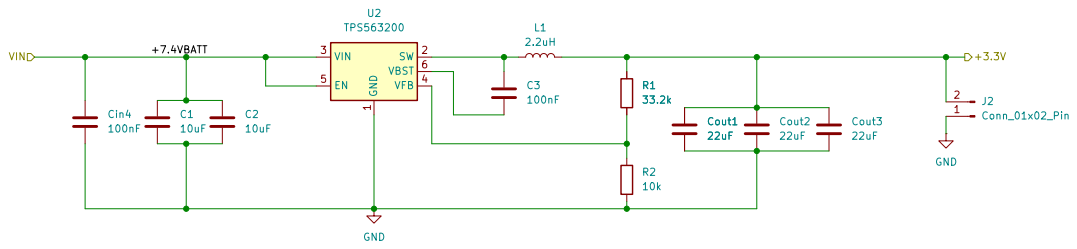
[picture p24: page 2]

Sheet: /Power Delivery System/ GND

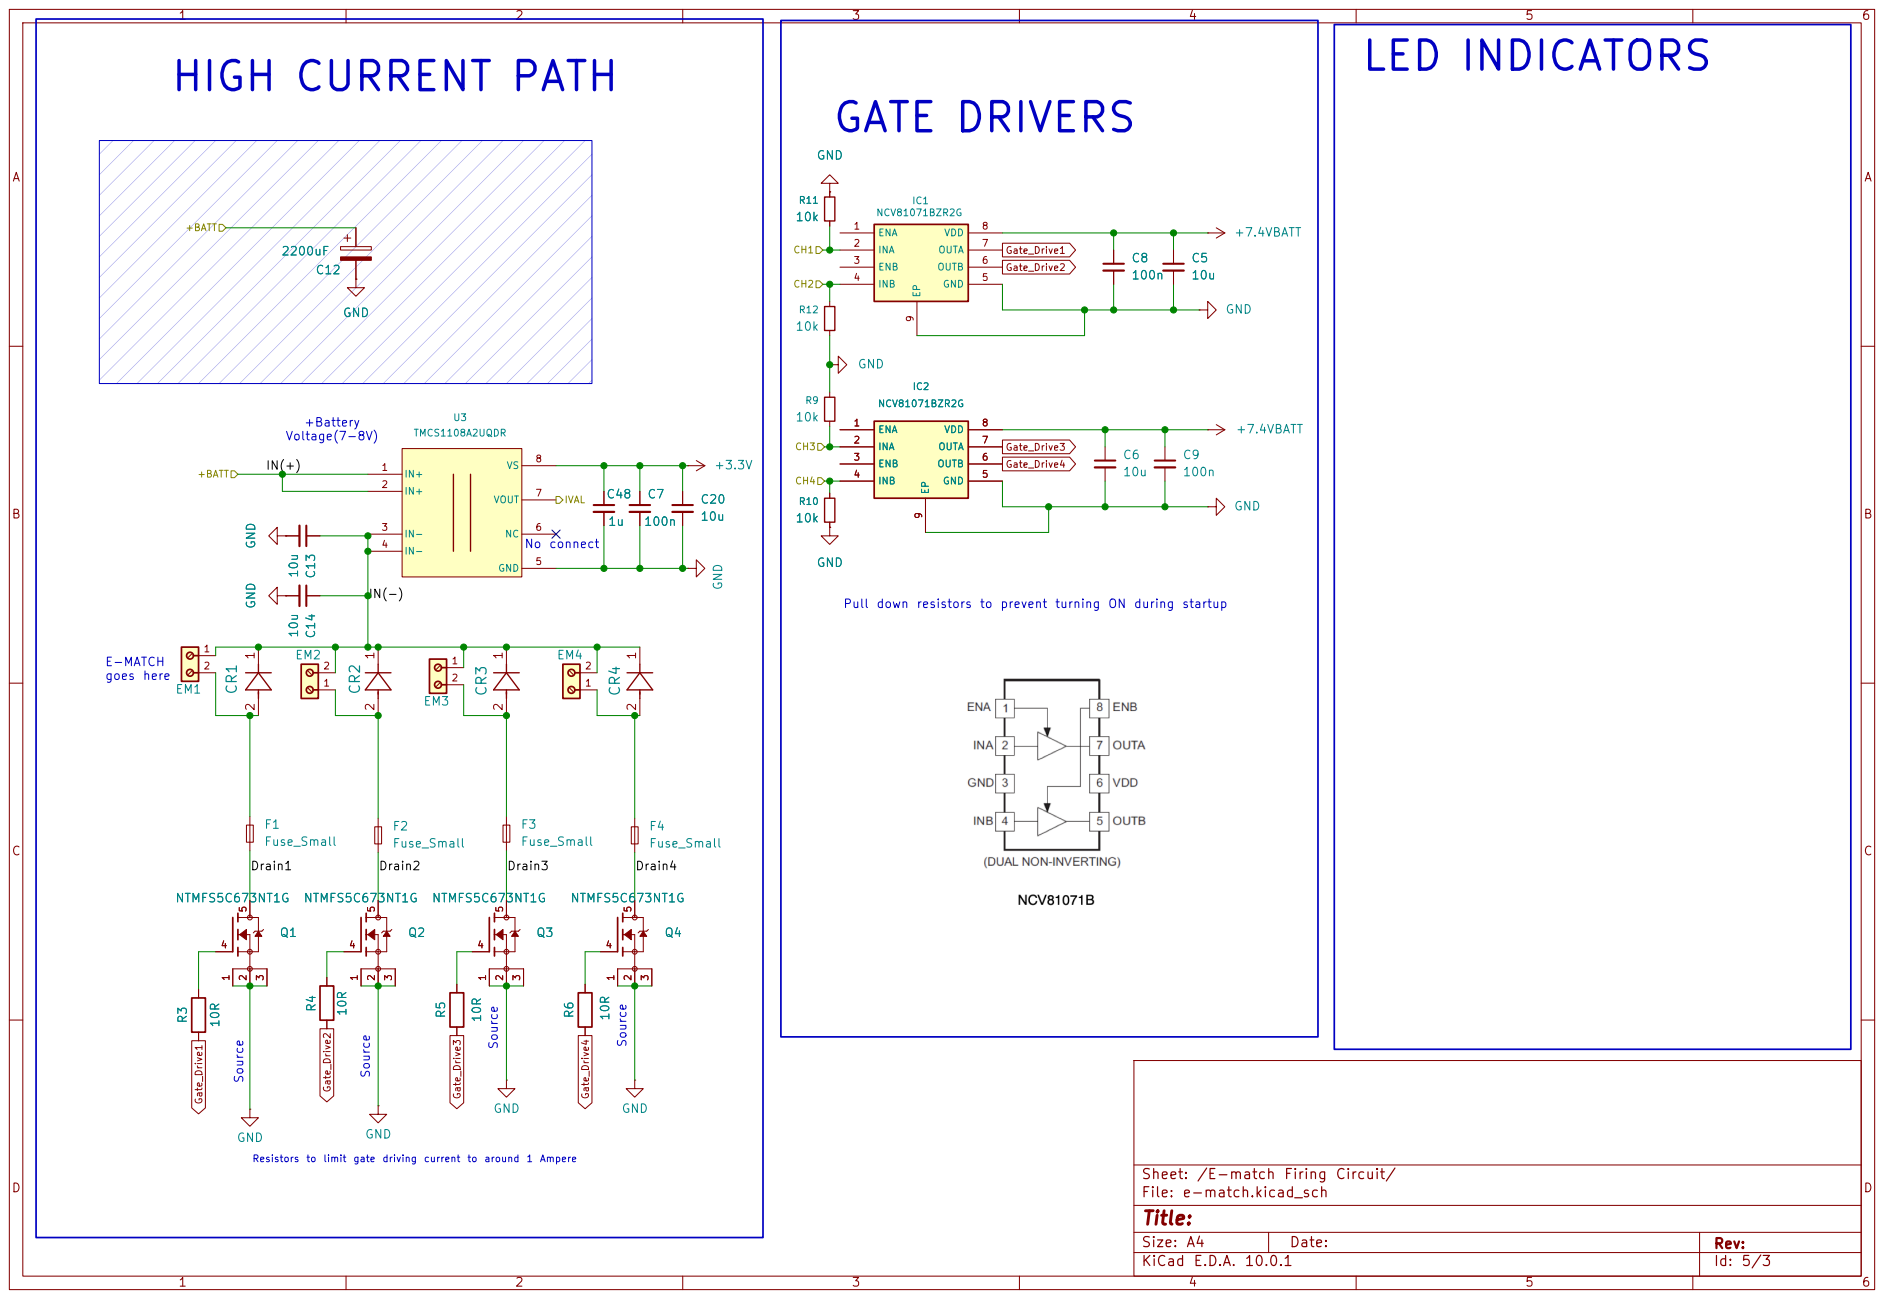
[picture p25: page 3]

HIGH CURRENT PATH Source Source
2200uF GND Q1 NTMFS5C673NT1G

Sheet: /E-match Firing Circuit/
File: e-match.kicad_sch
Title:
