UMSATS/SRAD-AvionicsComputer/Breakout Boards/breakout_boards.kicad_pcb

## KiCad design Breakout Boards/breakout_boards.kicad_pcb (2026-11-12)

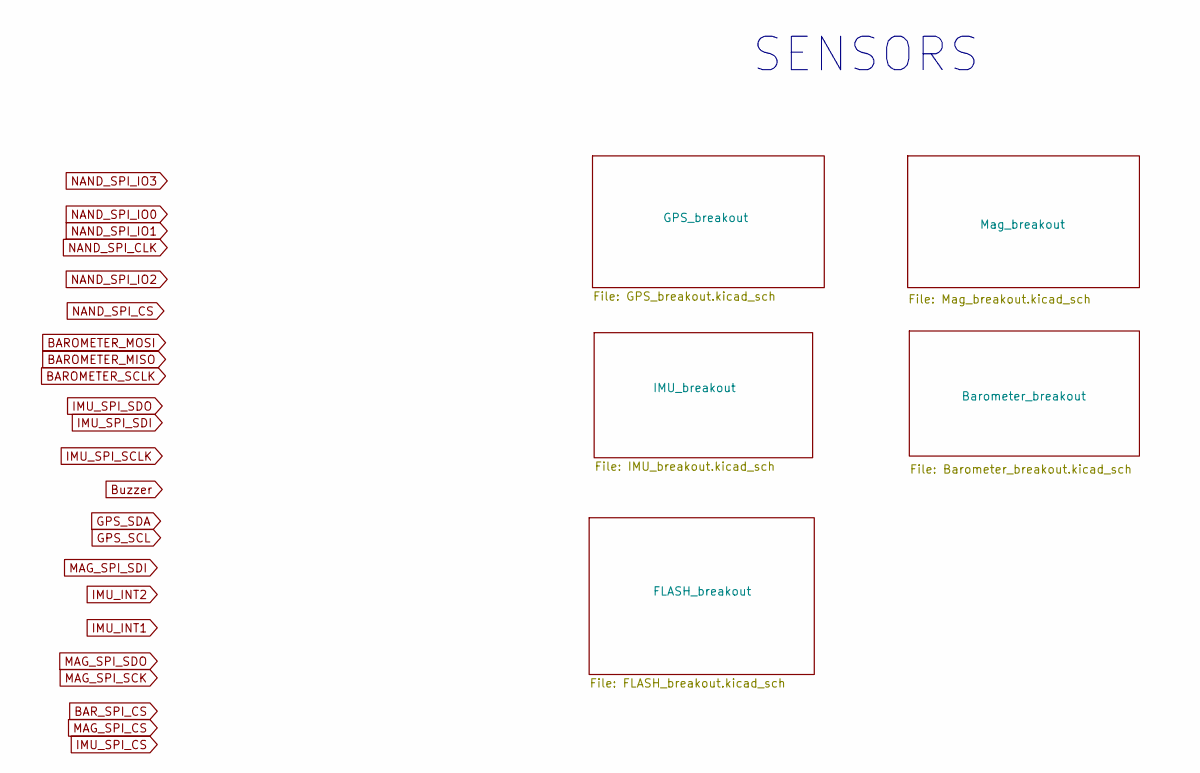
[picture p26: schematic breakout_boards.kicad_sch, Breakout Boards]

Notes on the sheet:
SENSORS

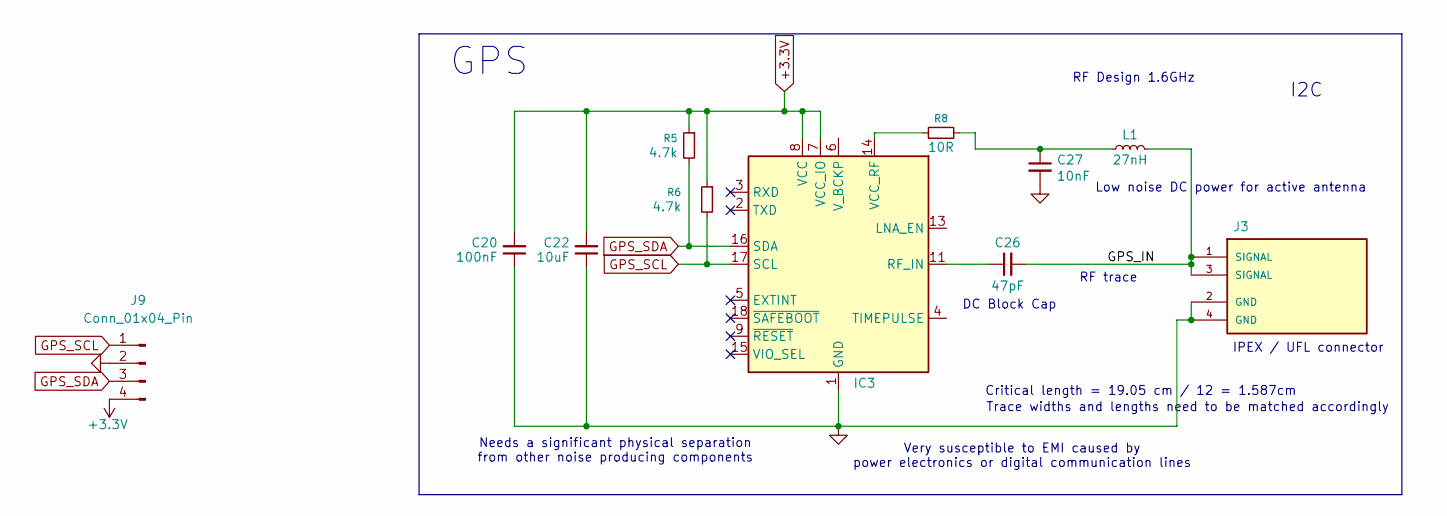
[picture p27: schematic GPS_breakout.kicad_sch]

Parts:
C20: 100nF; C_0603_1608Metric; Manufacturer_Part_Number C0603C104K5RAC3121
C22: 10uF; C_1206_3216Metric; Manufacturer_Part_Number CGA5L1X7R1E106K160DC
C26: 47pF; C_0402_1005Metric; Manufacturer_Part_Number C0402C470J3GACTU
C27: 10nF; C_0402_1005Metric; Manufacturer_Part_Number GRM155R71C103KA01D
IC3: ublox_MAX; Manufacturer_Part_Number MAX-M10S-00B
J3: SAMTEC_RSP-122811-02; Manufacturer_Part_Number RSP-122811-02
J9: Conn_01x04_Pin; PinHeader_1x04_P2.54mm_Vertical
L1: 27nH; L_0402_1005Metric; Manufacturer_Part_Number LQG15HS27NH02D
R5, R6: 4.7k; R_0603_1608Metric; Manufacturer_Part_Number CRCW06034K70FKEAHP
R8: 10R; R_1206_3216Metric; Manufacturer_Part_Number RC1206JR-7W10RL

Connections:
+3.3V: C20.2, C22.2, IC3.7 (VCC_IO), IC3.8 (VCC), J9.4, R5.1, R6.1; also elsewhere on the board
/GPS_breakout/GPS_IN: C26.2, J3.1 (SIGNAL), J3.3 (SIGNAL), L1.2
GND: C20.1, C22.1, C27.2, IC3.1 (GND), IC3.10 (GND), IC3.12 (GND), J3.2 (GND), J3.4 (GND), J9.2; also elsewhere on the board
GPS_SCL: IC3.17 (SCL), J9.1, R6.2
GPS_SDA: IC3.16 (SDA), J9.3, R5.2
unnamed: C27.1, L1.1, R8.2
unnamed: C26.1, IC3.11 (RF_IN)
unnamed: IC3.14 (VCC_RF), R8.1

Notes on the sheet:
Needs a significant physical separation from other noise producing components
Very susceptible to EMI caused by power electronics or digital communication lines
I2C
RF Design 1.6GHz
Critical length = 19.05 cm / 12 = 1.587cm
Trace widths and lengths need to be matched accordingly
IPEX / UFL connector
GPS
DC Block Cap
Low noise DC power for active antenna
RF trace

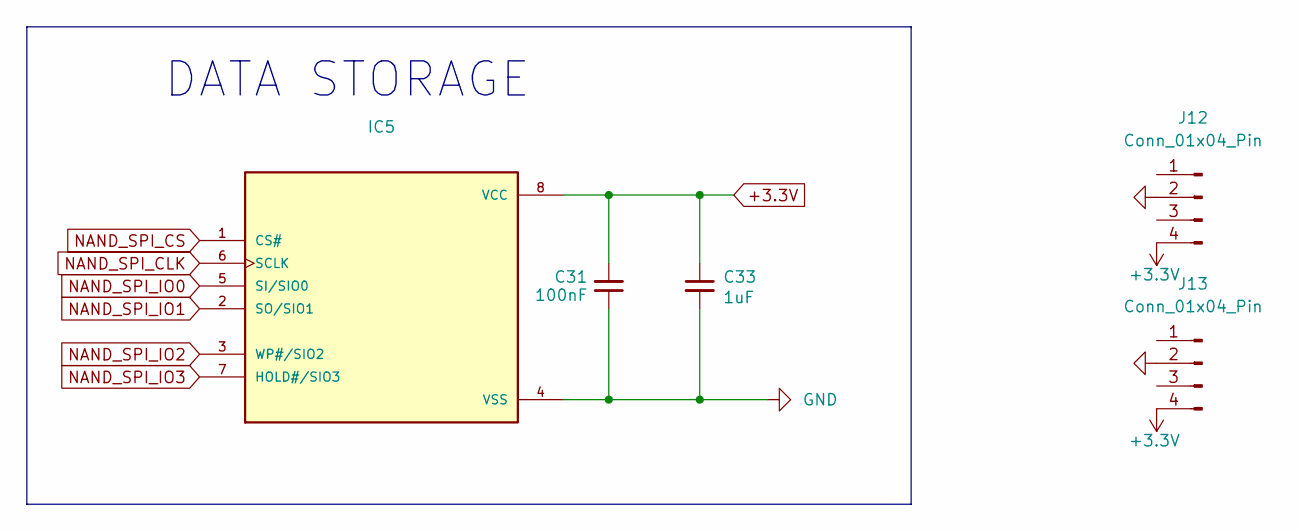
[picture p28: schematic FLASH_breakout.kicad_sch]

Parts:
C31: 100nF; C_0603_1608Metric; Manufacturer_Part_Number C0603C104K5RAC3121
C33: 1uF; C_0603_1608Metric; Manufacturer_Part_Number C0603C105K4RACTU
IC5: SON127P600X800X80-8N; PARTREV 1.0
J12, J13: Conn_01x04_Pin; PinHeader_1x04_P2.54mm_Vertical

Connections:
+3.3V: C31.2, C33.1, IC5.8 (VCC), J12.4, J13.4; also elsewhere on the board
GND: C31.1, C33.2, IC5.4 (VSS), J12.2, J13.2; also elsewhere on the board
NAND_SPI_CLK: IC5.6 (SCLK)
NAND_SPI_CS: IC5.1 (CS#)
NAND_SPI_IO0: IC5.5 (SI/SIO0)
NAND_SPI_IO1: IC5.2 (SO/SIO1)
NAND_SPI_IO2: IC5.3 (WP#/SIO2)
NAND_SPI_IO3: IC5.7 (HOLD#/SIO3)

Notes on the sheet:
DATA STORAGE

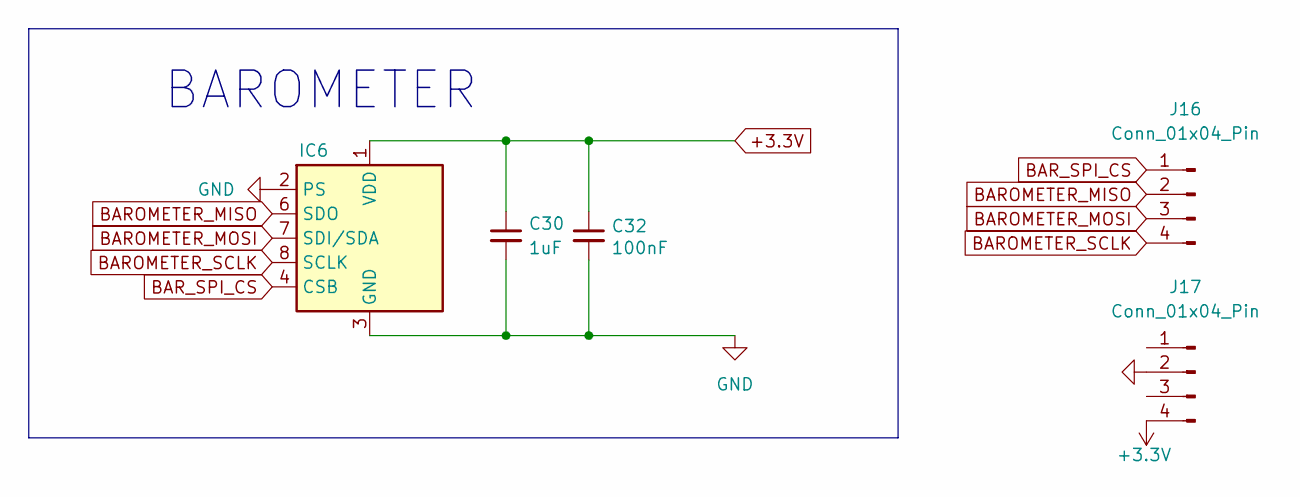
[picture p29: schematic Barometer_breakout.kicad_sch]

Parts:
C30: 1uF; C_0603_1608Metric; Manufacturer_Part_Number C0603C105K4RACTU
C32: 100nF; C_0603_1608Metric; Manufacturer_Part_Number C0603C104K5RAC3121
IC6: LGA-8_3x5mm_P1.25mm; Manufacturer_Part_Number MS560702BA03-50
J16, J17: Conn_01x04_Pin; PinHeader_1x04_P2.54mm_Vertical

Connections:
+3.3V: C30.1, C32.1, IC6.1 (VDD), J17.4; also elsewhere on the board
BAROMETER_MISO: IC6.6 (SDO), J16.2
BAROMETER_MOSI: IC6.7 (SDI/SDA), J16.3
BAROMETER_SCLK: IC6.8 (SCLK), J16.4
BAR_SPI_CS: IC6.4 (CSB), IC6.5 (CSB), J16.1
GND: C30.2, C32.2, IC6.2 (PS), IC6.3 (GND), J17.2; also elsewhere on the board

Notes on the sheet:
BAROMETER

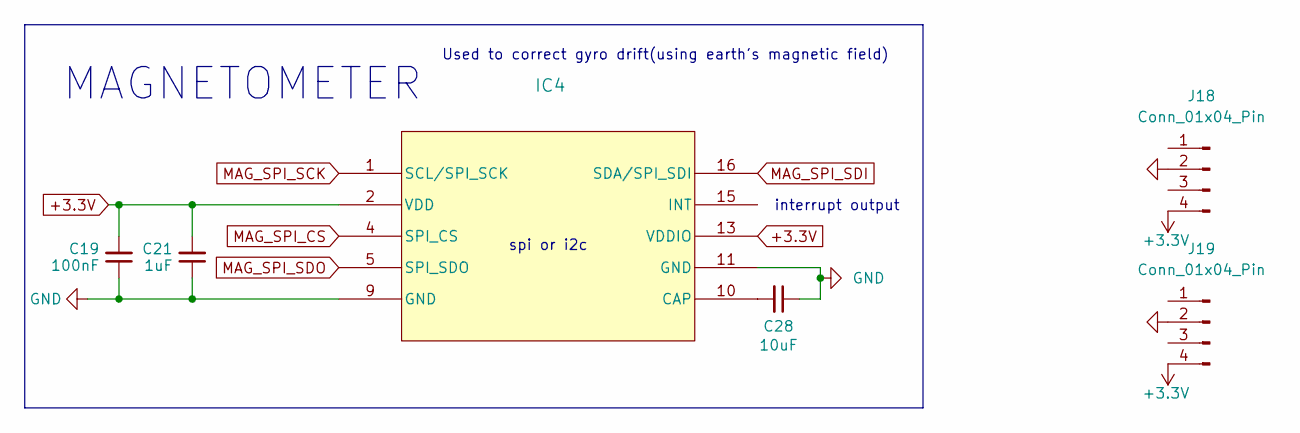
[picture p30: schematic Mag_breakout.kicad_sch]

Parts:
C19: 100nF; C_0603_1608Metric; Manufacturer_Part_Number C0603C104K5RAC3121
C21: 1uF; C_0603_1608Metric; Manufacturer_Part_Number C0603C105K4RACTU
C28: 10uF; C_1206_3216Metric; Manufacturer_Part_Number CGA5L1X7R1E106K160DC
IC4: MMC5983MA_MEM; Manufacturer_Part_Number MMC5983MA
J18, J19: Conn_01x04_Pin; PinHeader_1x04_P2.54mm_Vertical

Connections:
+3.3V: C19.2, C21.2, IC4.2 (VDD), IC4.13 (VDDIO), J18.4, J19.4; also elsewhere on the board
GND: C19.1, C21.1, C28.1, IC4.6 (NC), IC4.9 (GND), IC4.11 (GND), J18.2, J19.2; also elsewhere on the board
MAG_SPI_CS: IC4.3 (NC), IC4.4 (SPI_CS)
MAG_SPI_SCK: IC4.1 (SCL/SPI_SCK)
MAG_SPI_SDI: IC4.16 (SDA/SPI_SDI)
MAG_SPI_SDO: IC4.5 (SPI_SDO)
unnamed: C28.2, IC4.10 (CAP)

Notes on the sheet:
spi or i2c
interrupt output
MAGNETOMETER
Used to correct gyro drift(using earth's magnetic field)

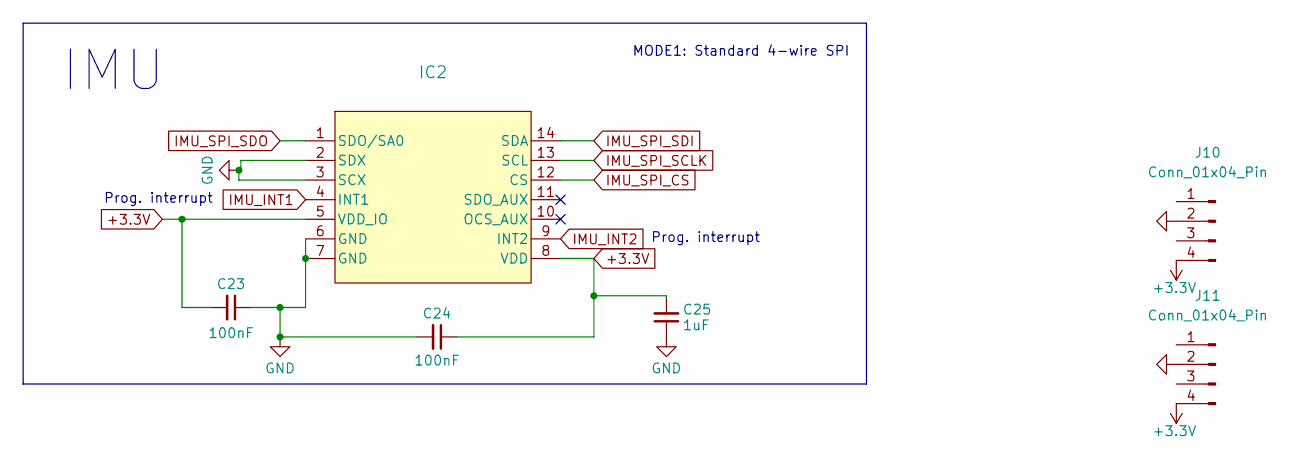
[picture p31: schematic IMU_breakout.kicad_sch]

Parts:
C23, C24: 100nF; C_0603_1608Metric; Manufacturer_Part_Number C0603C104K5RAC3121
C25: 1uF; C_0603_1608Metric; Manufacturer_Part_Number C0603C105K4RACTU
IC2: LGA14-L_2P59X3P1X0P5_STM; Manufacturer_Part_Number LSM6DSVTR
J10, J11: Conn_01x04_Pin; PinHeader_1x04_P2.54mm_Vertical

Connections:
+3.3V: C23.2, C24.1, C25.2, IC2.5 (VDD_IO), IC2.8 (VDD), J10.4, J11.4; also elsewhere on the board
GND: C23.1, C24.2, C25.1, IC2.2 (SDX), IC2.3 (SCX), IC2.6 (GND), IC2.7 (GND), J10.2, J11.2; also elsewhere on the board
IMU_INT1: IC2.4 (INT1)
IMU_INT2: IC2.9 (INT2)
IMU_SPI_CS: IC2.12 (CS)
IMU_SPI_SCLK: IC2.13 (SCL)
IMU_SPI_SDI: IC2.14 (SDA)
IMU_SPI_SDO: IC2.1 (SDO/SA0)

Notes on the sheet:
Prog. interrupt
IMU
MODE1: Standard 4-wire SPI

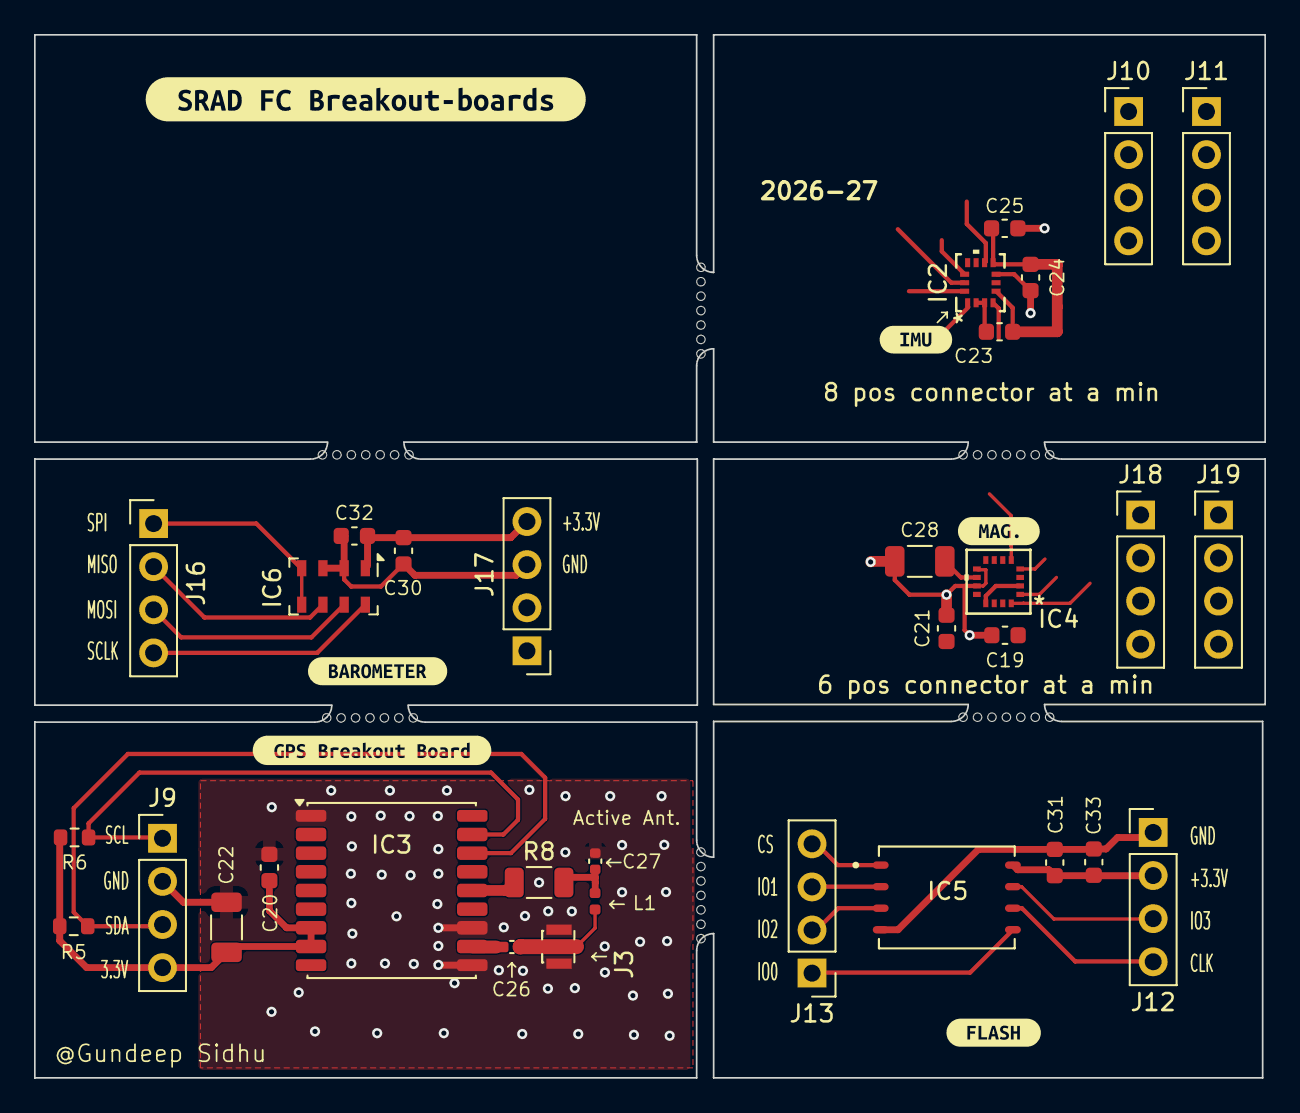
[picture p32: board breakout_boards.kicad_pcb from above]

Board: 2 copper layers, 72.5 x 61.5 mm, 39 parts (0 on the bottom side), 13 nets.

Other parts of the board:
kibuzzard-6A6394C9: G***; kibuzzard-6A6394C9
kibuzzard-6A6394D1: G***; kibuzzard-6A6394D1
kibuzzard-6A876244: G***; kibuzzard-6A876244
kibuzzard-6A982418: G***; kibuzzard-6A982418
kibuzzard-6AAC4875: G***; kibuzzard-6AAC4875
kibuzzard-6AB434CE: G***; kibuzzard-6AB434CE
