UMSATS/SRAD-AvionicsComputer/SRAD_V2/SRAD_V2.kicad_pcb

## KiCad design SRAD_V2/SRAD_V2.kicad_pcb (2026-10-17)

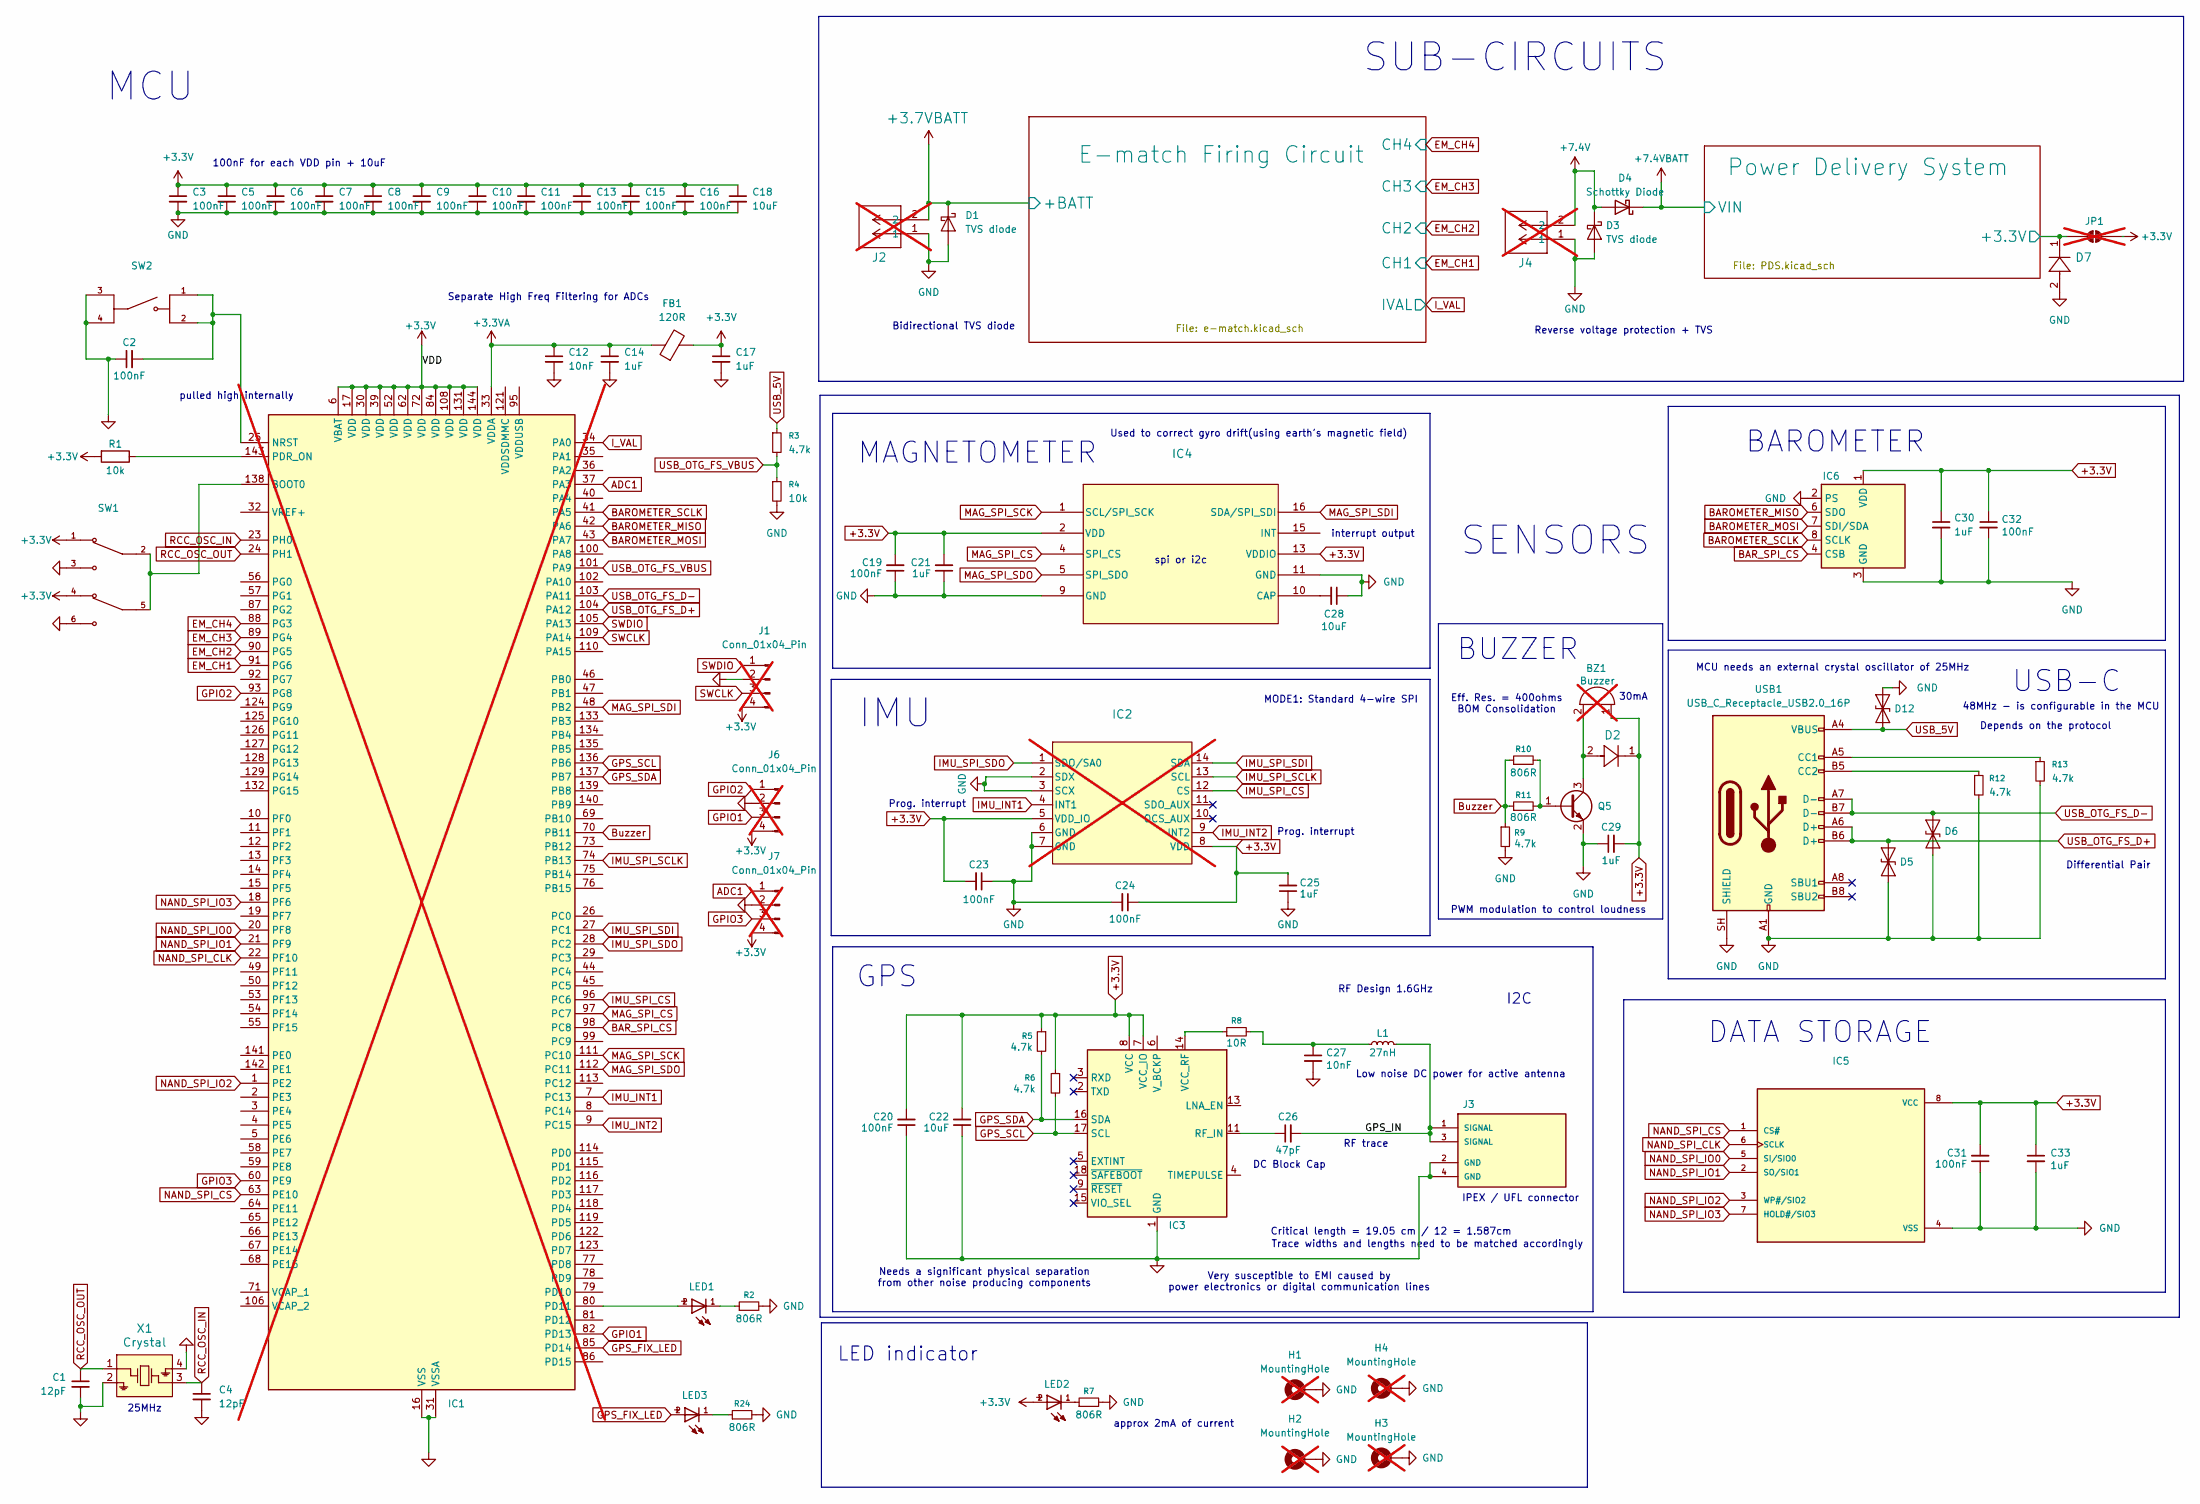
[picture p33: schematic SRAD_V2.kicad_sch, SRAD Flight Computer 2026]

Parts:
BZ1: Buzzer; Buzzer_12x9.5RM7.6; Manufacturer_Part_Number CI12E-05T230-C-6; not fitted
C1, C4: 12pF; C_0402_1005Metric; Manufacturer_Part_Number GRM1555C1H120FA01J
C2, C3, C5, C6, C7, C8, C9, C10, C11, C13, C15, C16, C19, C20, C23, C24, C31, C32: 100nF; C_0603_1608Metric; Manufacturer_Part_Number C0603C104K5RAC3121
C12, C27: 10nF; C_0402_1005Metric; Manufacturer_Part_Number GRM155R71C103KA01D
C14, C17, C21, C25, C29, C30, C33: 1uF; C_0603_1608Metric; Manufacturer_Part_Number C0603C105K4RACTU
C18, C22, C28: 10uF; C_1206_3216Metric; Manufacturer_Part_Number CGA5L1X7R1E106K160DC
C26: 47pF; C_0402_1005Metric; Manufacturer_Part_Number C0402C470J3GACTU
D1, D3: TVS diode; D_SOD-123F; Manufacturer_Part_Number SMF10CA
D2: DIODE_MSP3V3; Manufacturer_Part_Number MSS1P5-M3/89A
D4: Schottky Diode; D_SMA; Manufacturer_Part_Number MBRA340T3G
D5, D6, D12: TVS diode; D_SOD-323; Manufacturer_Part_Number STS321050B100
D7: TVS diode; CR_PTVS3V_NEX-L; Manufacturer_Part_Number PTVS3V3S1UTR,115
FB1: 120R; L_0603_1608Metric; Manufacturer_Part_Number MH1608-121Y
H1, H2, H3, H4: MountingHole; MountingHole_3.5mm_Pad_Via; not fitted
IC1: LQFP-144_20x20mm_P0.5mm; Manufacturer_Part_Number STM32F767ZIT6; not fitted
IC2: LGA14-L_2P59X3P1X0P5_STM; Manufacturer_Part_Number LSM6DSVTR; not fitted
IC3: ublox_MAX; Manufacturer_Part_Number MAX-M10S-00B
IC4: MMC5983MA_MEM; Manufacturer_Part_Number MMC5983MA
IC5: SON127P600X800X80-8N; PARTREV 1.0
IC6: LGA-8_3x5mm_P1.25mm; Manufacturer_Part_Number MS560702BA03-50
J1, J6, J7: Conn_01x04_Pin; PinHeader_1x04_P2.54mm_Vertical; not fitted
J2, J4: CONN2_S02B-XASS_295x496_JST; Manufacturer_Part_Number S02B-XASS-1; not fitted
J3: SAMTEC_RSP-122811-02; Manufacturer_Part_Number RSP-122811-02
JP1: SolderJumper_2_Open; SolderJumper-2_P1.3mm_Open_RoundedPad1.0x1.5mm; not fitted
L1: 27nH; L_0402_1005Metric; Manufacturer_Part_Number LQG15HS27NH02D
LED1, LED2, LED3: LED; WL-SMCW_1206; Manufacturer_Part_Number 150120SS75000
Q5: NPN BJT; SOT-23; Manufacturer_Part_Number MMBT3904LT3G
R1, R4: 10k; R_0603_1608Metric; Manufacturer_Part_Number CRT0603-BY-1002ELF
R2, R7, R10, R11, R24: 806R; R_0603_1608Metric; Manufacturer_Part_Number RT0603BRD07806RL
R3, R5, R6, R9, R12, R13: 4.7k; R_0603_1608Metric; Manufacturer_Part_Number CRCW06034K70FKEAHP
R8: 10R; R_1206_3216Metric; Manufacturer_Part_Number RC1206JR-7W10RL
SW1: SW_SLW-913535-2A-SMT; PARTREV 1.01
SW2: SW_TS18-5-15-SL-160-SMT-TR; PARTREV 1.02
USB1: USB_C_Receptacle_USB2.0_16P; USB_C_Receptacle_GCT_USB4105-xx-A_16P_TopMnt_Horizontal; Manufacturer_Part_Number USB4105-GF-A
X1: Crystal; VXM7_MCH; Manufacturer_Part_Number VXM7-9032-25M0000000

Connections:
+3.3V: BZ1.1 (+), C3.1, C5.1, C6.1, C7.1, C8.1, C9.1, C10.1, C11.1, C13.1, C15.1, C16.1, C17.1, C18.1, C19.2, C20.2, C21.2, C22.2, C23.2, C24.1, C25.2, C29.2, C30.1, C31.2, C32.1, C33.1, D2.1, FB1.2, IC1.6 (VBAT), IC1.17 (VDD), IC1.30 (VDD), IC1.39 (VDD), IC1.52 (VDD), IC1.62 (VDD), IC1.72 (VDD), IC1.84 (VDD), IC1.108 (VDD), IC1.131 (VDD), IC1.144 (VDD), IC2.5 (VDD_IO), IC2.8 (VDD), IC3.7 (VCC_IO), IC3.8 (VCC), IC4.2 (VDD), IC4.13 (VDDIO), IC5.8 (VCC), IC6.1 (VDD), J1.4, J6.4, J7.4, JP1.2 (B), LED2.2, R1.2, R5.1, R6.1, SW1.1, SW1.4; also elsewhere on the board
+3.3VA: C12.1, C14.1, FB1.1, IC1.33 (VDDA)
+3.7VBATT: D1.1 (K), J2.2; also elsewhere on the board
+7.4V: D3.1 (K), D4.2 (A), J4.2; also elsewhere on the board
+7.4VBATT: D4.1 (K); also elsewhere on the board
/GPS_IN: C26.2, J3.1 (SIGNAL), J3.3 (SIGNAL), L1.2
/Power Delivery System/+3.3V: D7.1, JP1.1 (A); also elsewhere on the board
ADC1: IC1.37 (PA3), J7.1
BAROMETER_MISO: IC1.42 (PA6), IC6.6 (SDO)
BAROMETER_MOSI: IC1.43 (PA7), IC6.7 (SDI/SDA)
BAROMETER_SCLK: IC1.41 (PA5), IC6.8 (SCLK)
BAR_SPI_CS: IC1.98 (PC8), IC6.4 (CSB), IC6.5 (CSB)
Buzzer: IC1.70 (PB11), R9.1, R10.1, R11.1
EM_CH1: IC1.91 (PG6); also elsewhere on the board
EM_CH2: IC1.90 (PG5); also elsewhere on the board
EM_CH3: IC1.89 (PG4); also elsewhere on the board
EM_CH4: IC1.88 (PG3); also elsewhere on the board
GND: C1.2, C2.1, C3.2, C4.2, C5.2, C6.2, C7.2, C8.2, C9.2, C10.2, C11.2, C12.2, C13.2, C14.2, C15.2, C16.2, C17.2, C18.2, C19.1, C20.1, C21.1, C22.1, C23.1, C24.2, C25.1, C27.2, C28.1, C29.1, C30.2, C31.1, C32.2, C33.2, D1.2 (A), D3.2 (A), D5.1 (A1), D6.1 (A1), D7.2, D12.2 (A2), H1.1 (1_1), H2.1 (1_1), H3.1 (1_1), H4.1 (1_1), IC1.16 (VSS), IC1.31 (VSSA), IC1.38 (VSS), IC1.51 (VSS), IC1.61 (VSS), IC1.83 (VSS), IC1.94 (VSS), IC1.107 (VSS), IC1.120 (VSS), IC1.130 (VSS), IC2.2 (SDX), IC2.3 (SCX), IC2.6 (GND), IC2.7 (GND), IC3.1 (GND), IC3.10 (GND), IC3.12 (GND), IC4.6 (NC), IC4.9 (GND), IC4.11 (GND), IC5.4 (VSS), IC6.2 (PS), IC6.3 (GND), J1.2, J2.1, J3.2 (GND), J3.4 (GND), J4.1, J6.2, J7.2, Q5.2 (E), R2.2, R4.2, R7.2, R9.2, R12.2, R13.2, R24.2, SW1.3, SW1.6, SW2.3, SW2.4, USB1.A1 (GND), USB1.A12 (GND), USB1.B1 (GND), USB1.B12 (GND), USB1.SH (SHIELD), X1.2, X1.4; also elsewhere on the board
GPIO1: IC1.82 (PD13), J6.3
GPIO2: IC1.93 (PG8), J6.1
GPIO3: IC1.60 (PE9), J7.3
GPS_FIX_LED: IC1.85 (PD14), LED3.2
GPS_SCL: IC1.136 (PB6), IC3.17 (SCL), R6.2
GPS_SDA: IC1.137 (PB7), IC3.16 (SDA), R5.2
IMU_INT1: IC1.7 (PC13), IC2.4 (INT1)
IMU_INT2: IC1.9 (PC15), IC2.9 (INT2)
IMU_SPI_CS: IC1.96 (PC6), IC2.12 (CS)
IMU_SPI_SCLK: IC1.74 (PB13), IC2.13 (SCL)
IMU_SPI_SDI: IC1.27 (PC1), IC2.14 (SDA)
IMU_SPI_SDO: IC1.28 (PC2), IC2.1 (SDO/SA0)
I_VAL: IC1.34 (PA0); also elsewhere on the board
MAG_SPI_CS: IC1.97 (PC7), IC4.3 (NC), IC4.4 (SPI_CS)
MAG_SPI_SCK: IC1.111 (PC10), IC4.1 (SCL/SPI_SCK)
MAG_SPI_SDI: IC1.48 (PB2), IC4.16 (SDA/SPI_SDI)
MAG_SPI_SDO: IC1.112 (PC11), IC4.5 (SPI_SDO)
NAND_SPI_CLK: IC1.22 (PF10), IC5.6 (SCLK)
NAND_SPI_CS: IC1.63 (PE10), IC5.1 (CS#)
NAND_SPI_IO0: IC1.20 (PF8), IC5.5 (SI/SIO0)
NAND_SPI_IO1: IC1.21 (PF9), IC5.2 (SO/SIO1)
NAND_SPI_IO2: IC1.1 (PE2), IC5.3 (WP#/SIO2)
NAND_SPI_IO3: IC1.18 (PF6), IC5.7 (HOLD#/SIO3)
unnamed: BZ1.2 (-), D2.2, Q5.3 (C)
unnamed: C27.1, L1.1, R8.2
unnamed: IC1.138 (BOOT0), SW1.2, SW1.5
unnamed: C2.2, IC1.25 (NRST), SW2.1, SW2.2
unnamed: IC1.80 (PD11), LED1.2
unnamed: IC1.143 (PDR_ON), R1.1
unnamed: C26.1, IC3.11 (RF_IN)
unnamed: IC3.14 (VCC_RF), R8.1
unnamed: C28.2, IC4.10 (CAP)
unnamed: LED1.1, R2.1
unnamed: LED2.1, R7.1
unnamed: LED3.1, R24.1
unnamed: Q5.1 (B), R10.2, R11.2
unnamed: R13.1, USB1.A5 (CC1)
unnamed: R12.1, USB1.B5 (CC2)
RCC_OSC_IN: C4.1, IC1.23 (PH0), X1.3
RCC_OSC_OUT: C1.1, IC1.24 (PH1), X1.1
SWCLK: IC1.109 (PA14), J1.3
SWDIO: IC1.105 (PA13), J1.1
USB_5V: D12.1 (A1), R3.1, USB1.A4 (VBUS), USB1.A9 (VBUS), USB1.B4 (VBUS), USB1.B9 (VBUS)
USB_OTG_FS_D+: D5.2 (A2), IC1.104 (PA12), USB1.A6 (D+), USB1.B6 (D+)
USB_OTG_FS_D-: D6.2 (A2), IC1.103 (PA11), USB1.A7 (D-), USB1.B7 (D-)
USB_OTG_FS_VBUS: IC1.101 (PA9), R3.2, R4.1

Notes on the sheet:
48MHz - is configurable in the MCU
DATA STORAGE
Trace widths and lengths need to be matched accordingly
Reverse voltage protection + TVS
Differential Pair
RF trace
25MHz
MODE1: Standard 4-wire SPI
Very susceptible to EMI caused by power electronics or digital communication lines
MAGNETOMETER
BUZZER
Critical length = 19.05 cm / 12 = 1.587cm
SENSORS
Depends on the protocol
30mA
RF Design 1.6GHz
pulled high internally
Prog. interrupt
Eff. Res. = 400ohms BOM Consolidation
Bidirectional TVS diode
LED indicator
Needs a significant physical separation from other noise producing components
MCU
Used to correct gyro drift(using earth's magnetic field)
I2C
approx 2mA of current
USB-C
spi or i2c
DC Block Cap
IMU
100nF for each VDD pin + 10uF
GPS
PWM modulation to control loudness
interrupt output
SUB-CIRCUITS
MCU needs an external crystal oscillator of 25MHz
IPEX / UFL connector
Separate High Freq Filtering for ADCs
Low noise DC power for active antenna
BAROMETER

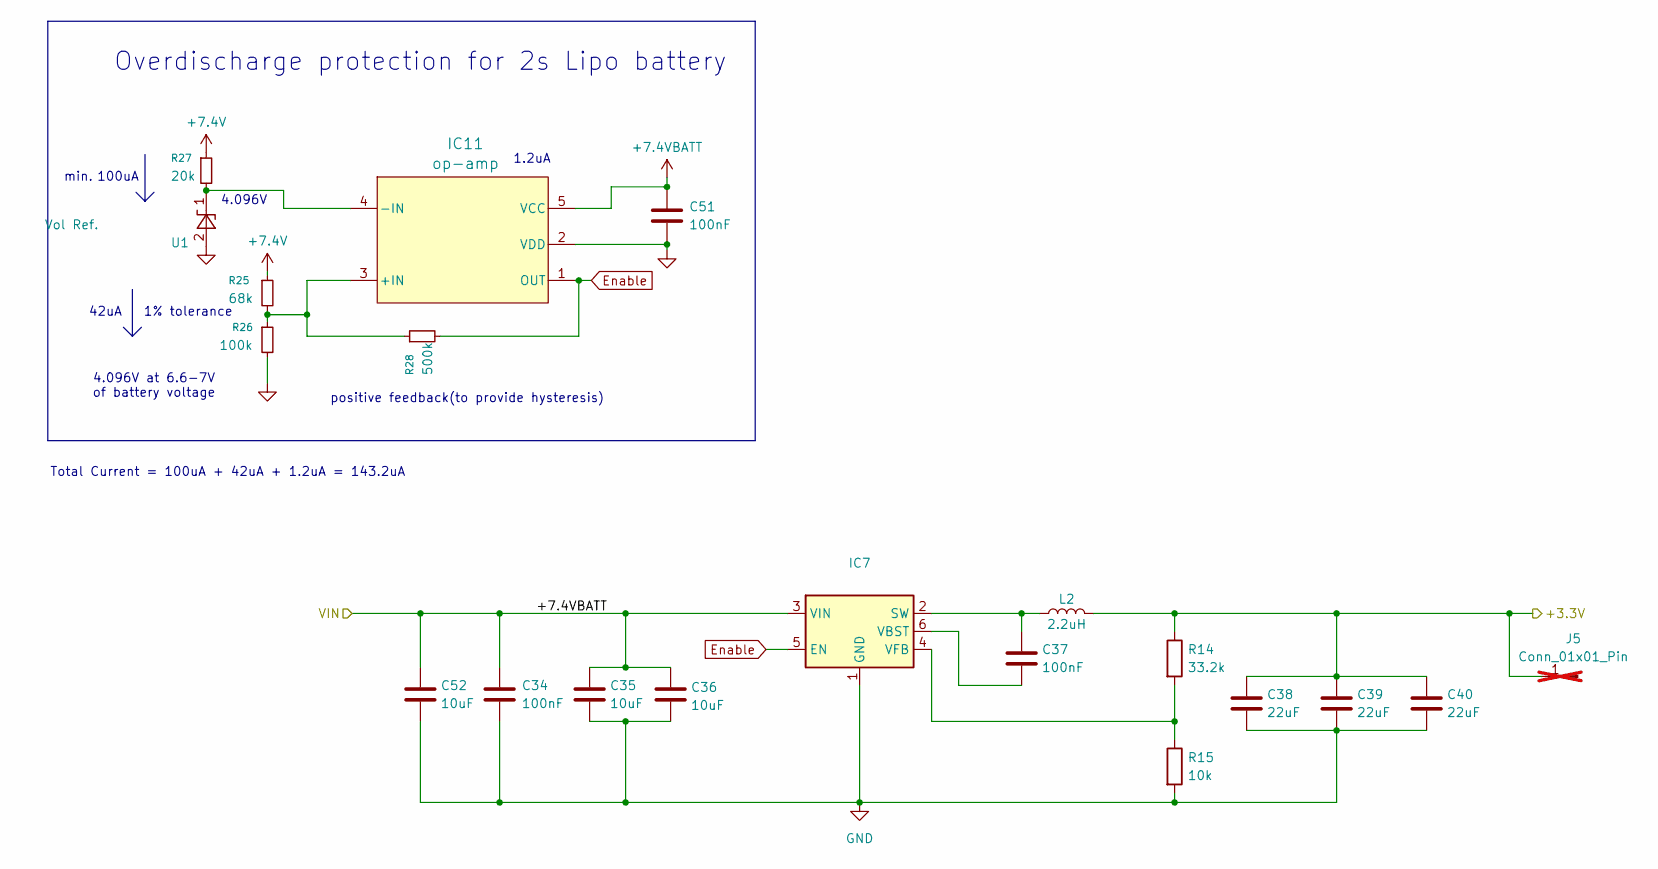
[picture p34: schematic PDS.kicad_sch]

Parts:
C34, C37, C51: 100nF; C_0603_1608Metric; Manufacturer_Part_Number C0603C104K5RAC3121
C35, C36, C52: 10uF; C_1206_3216Metric; Manufacturer_Part_Number CGA5L1X7R1E106K160DC
C38, C39, C40: 22uF; C_1206_3216Metric; Manufacturer_Part_Number GRM31CC81E226ME11L
IC7: SOT-23-6; Manufacturer_Part_Number TPS563200DDCT
IC11: op-amp; SOT23-5L_STM; Manufacturer_Part_Number TS941ILT
J5: Conn_01x01_Pin; PinHeader_1x01_P1.27mm_Vertical; not fitted
L2: 2.2uH; L_Bourns_SRP5030T; Manufacturer_Part_Number SRP5030TA-2R2M
R14: 33.2k; R_0603_1608Metric; Manufacturer_Part_Number CRCW060333K2FKTA
R15: 10k; R_0603_1608Metric; Manufacturer_Part_Number CRT0603-BY-1002ELF
R25: 68k; R_0603_1608Metric; Manufacturer_Part_Number CRG0603F68K
R26: 100k; R_0603_1608Metric; Manufacturer_Part_Number RT0603FRD07100KL
R27: 20k; R_0603_1608Metric; Manufacturer_Part_Number RMCF0603JT20K0
R28: 500k; R_0603_1608Metric; Manufacturer_Part_Number RT0603FRE07510KL
U1: Vol Ref.; SOT-23; MPN LM4040CYM3-4.1-TR

Connections:
+7.4V: R25.1, R27.1; also elsewhere on the board
+7.4VBATT: C34.1, C35.1, C36.1, C51.1, C52.1, IC7.3 (VIN), IC11.5 (VCC); also elsewhere on the board
/Power Delivery System/+3.3V: C38.1, C39.1, C40.1, J5.1 (Pin_1_1), L2.2, R14.1; also elsewhere on the board
Enable: IC7.5 (EN), IC11.1 (OUT), R28.2
GND: C34.2, C35.2, C36.2, C38.2, C39.2, C40.2, C51.2, C52.2, IC7.1 (GND), IC11.2 (VDD), R15.2, R26.2, U1.2 (A); also elsewhere on the board
unnamed: C37.1, IC7.2 (SW), L2.1
unnamed: C37.2, IC7.6 (VBST)
unnamed: IC7.4 (VFB), R14.2, R15.1
unnamed: IC11.3 (+IN), R25.2, R26.1, R28.1
unnamed: IC11.4 (-IN), R27.2, U1.1 (K)

Notes on the sheet:
4.096V at 6.6-7V of battery voltage
100uA
Overdischarge protection for 2s Lipo battery
1% tolerance
Total Current = 100uA + 42uA + 1.2uA = 143.2uA
positive feedback(to provide hysteresis)
42uA
min.
1.2uA
4.096V

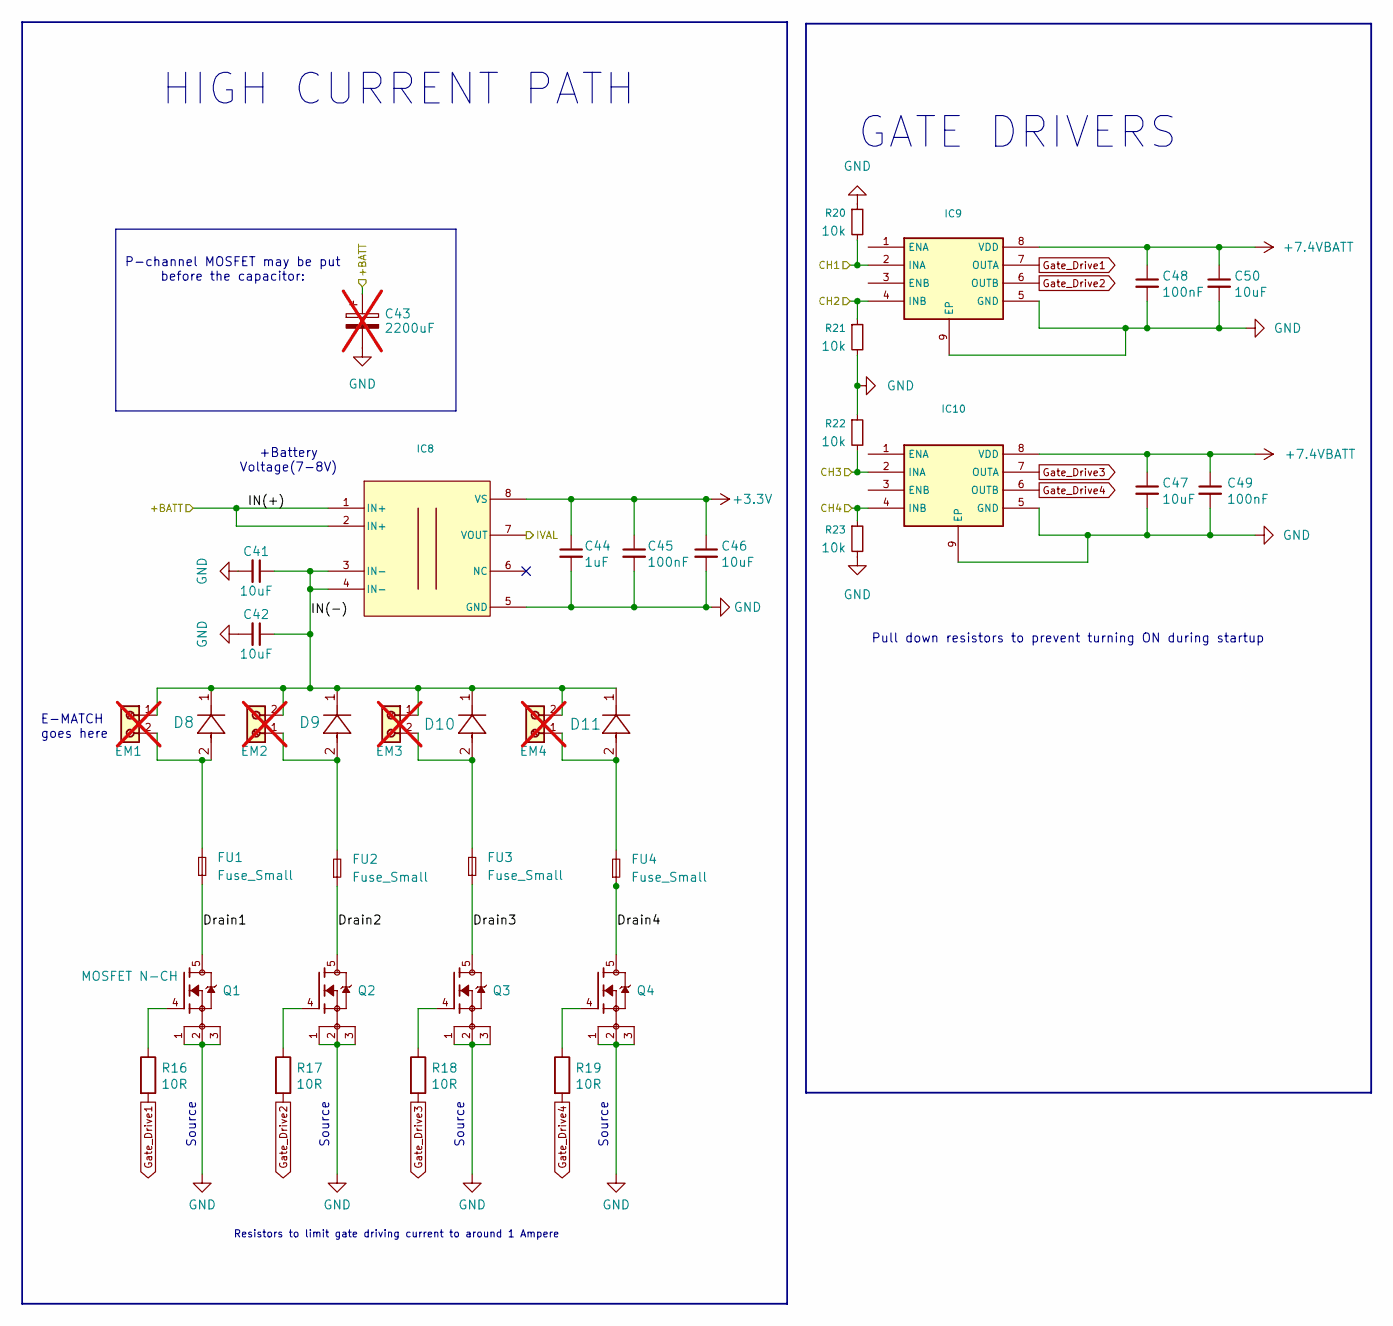
[picture p35: schematic e-match.kicad_sch]

Parts:
C41, C42, C46, C47, C50: 10uF; C_1206_3216Metric; Manufacturer_Part_Number CGA5L1X7R1E106K160DC
C43: 2200uF; CP_Radial_D10.0mm_P5.00mm; Manufacturer_Part_Number A750MW228M1CAAE010; not fitted
C44: 1uF; C_0603_1608Metric; Manufacturer_Part_Number C0603C105K4RACTU
C45, C48, C49: 100nF; C_0603_1608Metric; Manufacturer_Part_Number C0603C104K5RAC3121
D8, D9, D10, D11: DIODE_MSP3V3; Manufacturer_Part_Number MSS1P5-M3/89A
EM1, EM2, EM3, EM4: 691210910002; Manufacturer_Part_Number 691210910002; DigiKey_Part_Number 732-691210910002-ND; not fitted
FU1, FU2, FU3, FU4: Fuse_Small; Fuse_1206_3216Metric_Pad1.42x1.75mm_HandSolder; Manufacturer_Part_Number SF-1206SP500M-2
IC8: D0008A-IPC_A; Manufacturer_Part_Number TMCS1108A2UQDR
IC9, IC10: SOP65P490X110-9N; Manufacturer_Part_Number NCV81071BZR2G
Q1, Q2, Q3, Q4: MOSFET N-CH; TRANS_NTMFS5C673NT1G; PARTREV 0
R16, R17, R18, R19: 10R; R_1206_3216Metric; Manufacturer_Part_Number RC1206JR-7W10RL
R20, R21, R22, R23: 10k; R_0603_1608Metric; Manufacturer_Part_Number CRT0603-BY-1002ELF

Connections:
+3.3V: C44.1, C45.1, C46.1, IC8.8 (VS); also elsewhere on the board
+3.7VBATT: C43.1, IC8.1 (IN+), IC8.2 (IN+); also elsewhere on the board
+7.4VBATT: C47.1, C48.1, C49.1, C50.1, IC9.8 (VDD), IC10.8 (VDD); also elsewhere on the board
/E-match Firing Circuit/Drain1: FU1.1, Q1.5
/E-match Firing Circuit/Drain2: FU2.1, Q2.5
/E-match Firing Circuit/Drain3: FU3.1, Q3.5
/E-match Firing Circuit/Drain4: FU4.1, Q4.5
/E-match Firing Circuit/IN(-): C41.1, C42.1, D8.1, D9.1, D10.1, D11.1, EM1.1, EM2.2, EM3.1, EM4.2, IC8.3 (IN-), IC8.4 (IN-)
EM_CH1: IC9.2 (INA), R20.2; also elsewhere on the board
EM_CH2: IC9.4 (INB), R21.1; also elsewhere on the board
EM_CH3: IC10.2 (INA), R22.2; also elsewhere on the board
EM_CH4: IC10.4 (INB), R23.1; also elsewhere on the board
GND: C41.2, C42.2, C43.2, C44.2, C45.2, C46.2, C47.2, C48.2, C49.2, C50.2, IC8.5 (GND), IC9.5 (GND), IC9.9 (EP), IC10.5 (GND), IC10.9 (EP), Q1.1, Q1.2, Q1.3, Q2.1, Q2.2, Q2.3, Q3.1, Q3.2, Q3.3, Q4.1, Q4.2, Q4.3, R20.1, R21.2, R22.1, R23.2; also elsewhere on the board
Gate_Drive1: IC9.7 (OUTA), R16.2
Gate_Drive2: IC9.6 (OUTB), R17.2
Gate_Drive3: IC10.7 (OUTA), R18.2
Gate_Drive4: IC10.6 (OUTB), R19.2
I_VAL: IC8.7 (VOUT); also elsewhere on the board
unnamed: D8.2, EM1.2, FU1.2
unnamed: D9.2, EM2.1, FU2.2
unnamed: D10.2, EM3.2, FU3.2
unnamed: D11.2, EM4.1, FU4.2
unnamed: Q1.4, R16.1
unnamed: Q2.4, R17.1
unnamed: Q3.4, R18.1
unnamed: Q4.4, R19.1

Notes on the sheet:
Source
+Battery Voltage(7-8V)
Resistors to limit gate driving current to around 1 Ampere
E-MATCH goes here
HIGH CURRENT PATH
GATE DRIVERS
P-channel MOSFET may be put before the capacitor:
Pull down resistors to prevent turning ON during startup
