UMSATS/SRAD-AvionicsComputer/SRAD_V2/SRAD_V2.kicad_pcb

## KiCad design SRAD_V2/SRAD_V2.kicad_pcb (continued)

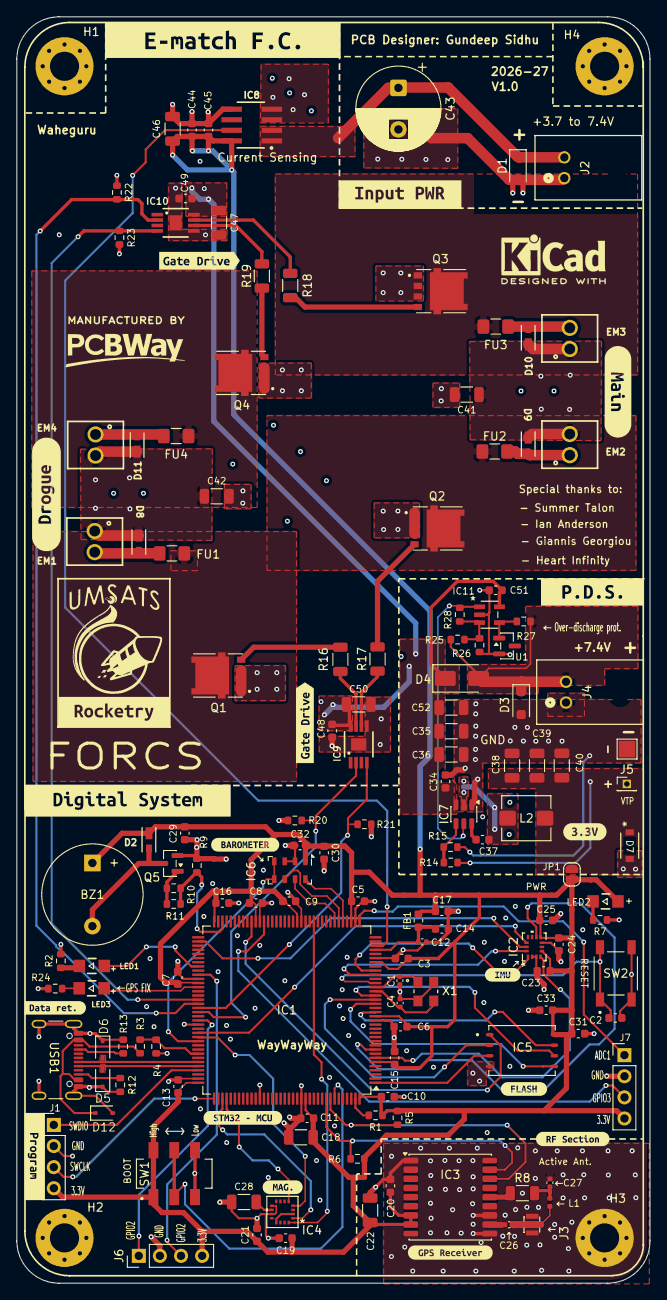
[picture p36: board SRAD_V2.kicad_pcb from above]

Board: 4 copper layers, 76.2 x 152.4 mm, 159 parts (0 on the bottom side), 87 nets.

Other parts of the board:
kibuzzard-6A3D75FD: G***; kibuzzard-6A3D75FD
kibuzzard-6A95C1A9: G***; kibuzzard-6A95C1A9
kibuzzard-6A95C5A9: G***; kibuzzard-6A95C5A9
kibuzzard-6A95C150: G***; kibuzzard-6A95C150
kibuzzard-6A95C804: G***; kibuzzard-6A95C804
kibuzzard-6A95CBD7: G***; kibuzzard-6A95CBD7
kibuzzard-6A95CC6E: G***; kibuzzard-6A95CC6E
kibuzzard-6A95CC9C: G***; kibuzzard-6A95CC9C
kibuzzard-6A6394C9: G***; kibuzzard-6A6394C9
kibuzzard-6A6394D1: G***; kibuzzard-6A6394D1
kibuzzard-6A9050F6: G***; kibuzzard-6A9050F6
kibuzzard-6A9704D1: G***; kibuzzard-6A9704D1
kibuzzard-6A876244: G***; kibuzzard-6A876244
kibuzzard-6A982418: G***; kibuzzard-6A982418
kibuzzard-6ABFFFA9: G***; kibuzzard-6ABFFFA9
kibuzzard-6AC0F9EB: G***; kibuzzard-6AC0F9EB
kibuzzard-6AC0FA62: G***; kibuzzard-6AC0FA62
kibuzzard-6AC04A03: G***; kibuzzard-6AC04A03
kibuzzard-6AC049EA: G***; kibuzzard-6AC049EA
