UMSATS/SRAD-AvionicsComputer/SRAD_V1/Avionics_SRAD.kicad_pcb

## KiCad design SRAD_V1/Avionics_SRAD.kicad_pcb (2026-02-21, an earlier design)

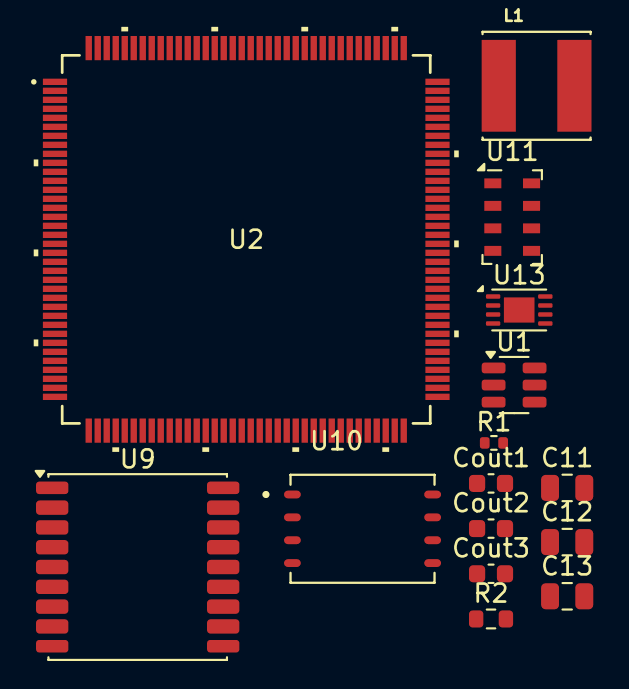
[picture p37: board Avionics_SRAD.kicad_pcb from above]

Board: 2 copper layers, 15 parts (0 on the bottom side), 7 nets, no tracks yet.

Parts:
C11, C13: 10uF; C_0805_2012Metric
C12: 100nF; C_0805_2012Metric
Cout1, Cout2, Cout3: 22uF; C_0603_1608Metric
L1: 2.2uH; IND_VLS6045EX-2R2N
R1: 33.2k; R_0402_1005Metric
R2: 10k; R_0603_1608Metric
U1: TPS563200; SOT-23-6
U2: STM32F767ZIT6; LQFP144-20x20mm_STM
U9: MAX-M10S; ublox_MAX
U10: AS5F31G04SND-08LIN; SON127P600X800X80-8N
U11: MS5607-02BA; LGA-8_3x5mm_P1.25mm
U13: MCP9808_DFN; DFN-8-1EP_3x2mm_P0.5mm_EP1.7x1.4mm

Connections:
GND: C11.2, C13.2, Cout1.2, Cout2.2, Cout3.2, R2.2, U1.1 (GND), U9.1 (GND), U9.10 (GND), U9.12 (GND), U10.4 (VSS), U11.3 (GND), U13.4 (GND)
unnamed: C12.1, L1.1, U1.2 (SW)
unnamed: C12.2, U1.6 (VBST)
unnamed: R1.2, R2.1, U1.4 (VFB)
unnamed: U11.4 (CSB), U11.5 (CSB)
V3V3: Cout1.1, Cout2.1, Cout3.1, L1.2, R1.1, U9.8 (VCC), U10.8 (VCC), U11.1 (VDD), U13.8 (V_{DD})
VIN: C11.1, C13.1, U1.3 (VIN), U1.5 (EN)
