UMSATS/SRAD-AvionicsComputer/(commit log)

2025-06-01 Initial commit: upload KiCad Avionics SRAD project
2025-06-10 Corrected footprint assignment errors
2025-09-23 Updated SRAD folder structure and schematic
2025-09-23 Updated SRAD_V1 schematic
2026-02-21 added correct models and linked footprints
2026-03-08 new connector
2026-03-16 added text-box for communication protocols in the schematic
2026-03-17 added bunch of decoupling capacitors, updated mosfet symbols with KICAD in-built ones etc
2026-03-20 fixed some origin issues on pcb -- working on the PDS
2026-03-21 PDS pcb layout
2026-05-07 updated MCU cad models
2026-05-08 added new IMU to the schematic
2026-05-09 Done with Pin Assignments
2026-05-12 routing for e-match circuit
2026-05-14 added magnometer e-cad model
2026-05-28 sensor routing
2026-06-01 Sensor routing and integration of various systems on the PCB
2026-07-21 Added an input LC filter
2026-08-01 Reorganising the PCB layout
2026-08-11 Added important GPS circuitry
2026-08-19 Layout almost finalised!
    Only thing left is to connect and layout parts of the GPS and antenna! This was after changing the layer stackup from SGPS to SGGS with power being routed on the top giving seamless ground planes providing EMI protection and signal integrity to signals being routed via vias :)
2026-08-23 ensuring proper grounding in the layout
2026-08-27 Updated IMU sensor and generated Interactive BOM using a plugin
2026-08-29 Added the JST connectors
2026-09-03 Merged the new schematic with the main project successfully!
2026-09-04 Added External GPIO/ADC headers
    Also impedance matched traces for USB and GPS input signal.
2026-09-05 Added GPS Led
2026-09-06 In the process of adding an over discharge protection for PDS battery
2026-09-14 Added component descriptions for BOM and added logos on silkscreen
2026-09-19 updated mounting hole dimensions
2026-09-25 Created Breakout Board Project
2026-09-28 Updated the 3.3V test point
2026-10-17 Minor changes
    Minor changes to the srad fab layer(added dimensions) and two traces in the GPS breakout board.
2026-10-17 Created a PCB layout for the Barometer
2026-10-17 changed the board stackup for breakout boards
    from 4 layer to 2 layer
2026-11-12 Breakout board redo
    Redid the FLASH and BAROMETER breakout boards to not use vias
2026-11-12 Done with 3, 2 more to go (breakout boards)
